hairymnstr/d1000_hardware/(threads)

Thread 1 (2023-10-13):

C11 and C12 should be 0603 not 0805

hairymnstr, 2023-10-13:
Easy to bodge but footprint should be 0603
