hairymnstr/d1000_hardware/audio.kicad_sch

## KiCad design audio.kicad_sch (2023-09-26)

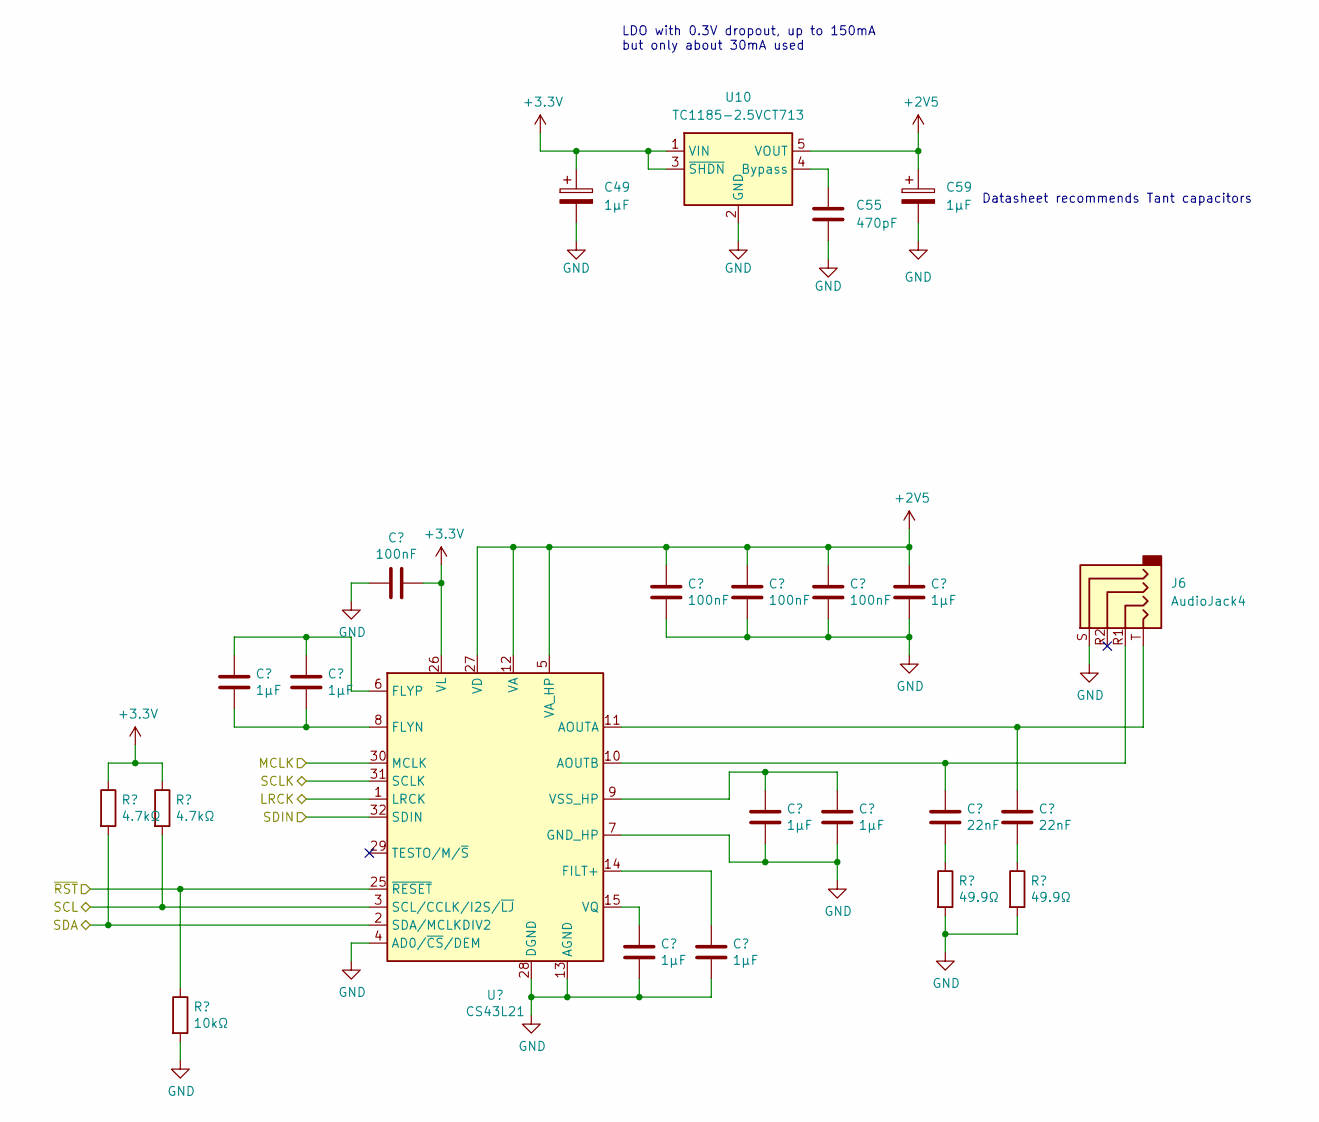
[picture p1: schematic audio.kicad_sch]

Parts:
C46, C47, C50, C52, C54, C57, C58: 1µF; C_0603_1608Metric_Pad1.08x0.95mm_HandSolder
C48, C51, C53, C56: 100nF; C_0603_1608Metric_Pad1.08x0.95mm_HandSolder; Part number Generic 0603 X7R 50V 10%
C49, C59: 1µF; CP_EIA-3216-12_Kemet-S_Pad1.58x1.35mm_HandSolder
C55: 470pF; C_0603_1608Metric_Pad1.08x0.95mm_HandSolder
C60, C61: 22nF; C_0603_1608Metric_Pad1.08x0.95mm_HandSolder
J6: AudioJack4; Cliff_Electronic_Components_Limited-FC68128-0
R59, R60: 4.7kΩ; R_0603_1608Metric_Pad0.98x0.95mm_HandSolder
R61: 10kΩ; R_0603_1608Metric_Pad0.98x0.95mm_HandSolder
R62, R63: 49.9Ω; R_0603_1608Metric_Pad0.98x0.95mm_HandSolder
U9: CS43L21; QFN-32-1EP_5x5mm_P0.5mm_EP3.45x3.45mm
U10: TC1185-2.5VCT713; SOT-23-5

Connections:
+2V5: C51.1, C53.1, C56.1, C58.1, C59.1, U9.5 (VA_HP), U9.12 (VA), U9.27 (VD), U10.5 (VOUT)
+3.3V: C48.1, C49.1, R59.1, R60.1, U9.26 (VL), U10.1 (VIN), U10.3 (~SHDN)
GND: C48.2, C49.2, C50.2, C51.2, C52.2, C53.2, C54.2, C55.2, C56.2, C57.2, C58.2, C59.2, J6.S, R61.2, R62.2, R63.2, U9.4 (AD0/~CS/DEM), U9.7 (GND_HP), U9.13 (AGND), U9.28 (DGND), U9.33 (AGND), U10.2 (GND)
LRCK: U9.1 (LRCK)
MCLK: U9.30 (MCLK)
unnamed: C46.1, C47.1, U9.6 (FLYP)
unnamed: C46.2, C47.2, U9.8 (FLYN)
unnamed: C50.1, U9.15 (VQ)
unnamed: C52.1, U9.14 (FILT+)
unnamed: C54.1, C57.1, U9.9 (VSS_HP)
unnamed: C55.1, U10.4 (Bypass)
unnamed: C60.1, J6.R1, U9.10 (AOUTB)
unnamed: C60.2, R62.1
unnamed: C61.1, J6.T, U9.11 (AOUTA)
unnamed: C61.2, R63.1
SCL: R60.2, U9.3 (SCL/CCLK/I2S/~LJ)
SCLK: U9.31 (SCLK)
SDA: R59.2, U9.2 (SDA/MCLKDIV2)
SDIN: U9.32 (SDIN)
~RST: R61.1, U9.25 (~RESET)

Notes on the sheet:
LDO with 0.3V dropout, up to 150mA but only about 30mA used
Datasheet recommends Tant capacitors
