hairymnstr/d1000_hardware/cpu.kicad_sch

## KiCad design cpu.kicad_sch (2023-09-26)

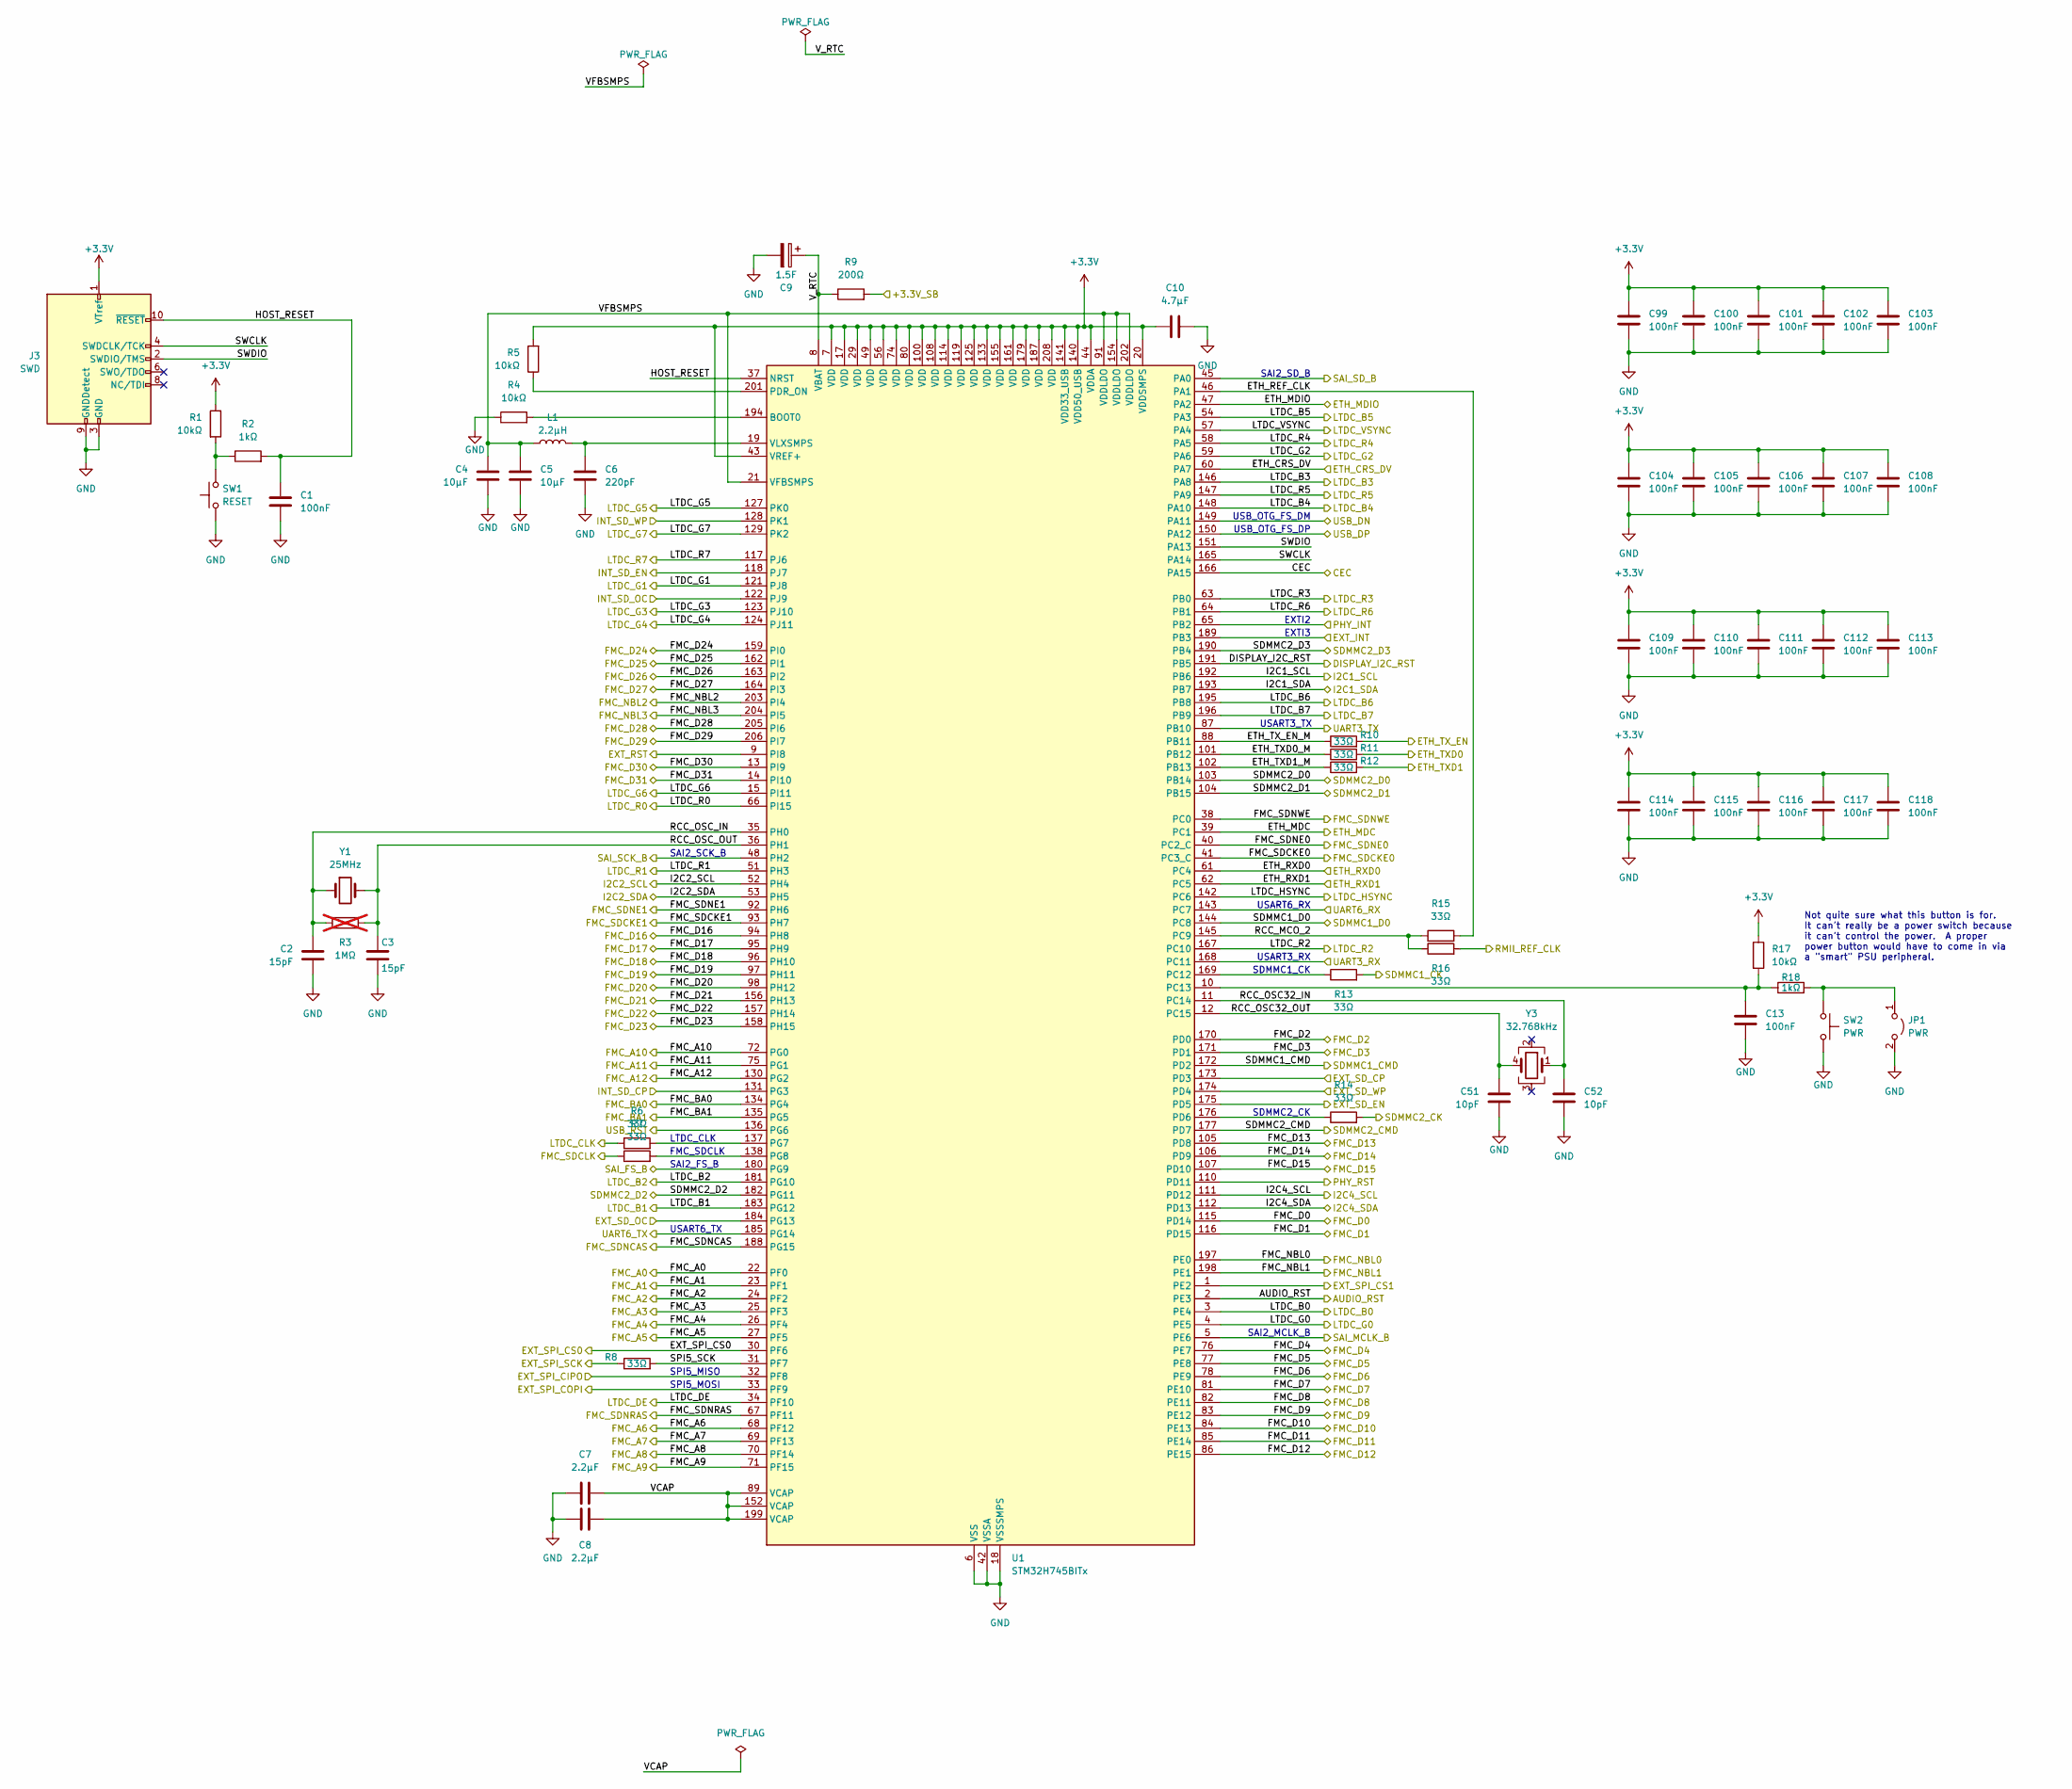
[picture p2: schematic cpu.kicad_sch]

Parts:
C1, C13: 100nF; C_0603_1608Metric_Pad1.08x0.95mm_HandSolder; Part number Generic 0603 X7R 50V 10%
C2, C3: 15pF; C_0603_1608Metric_Pad1.08x0.95mm_HandSolder
C4, C5: 10µF; C_0805_2012Metric_Pad1.18x1.45mm_HandSolder
C6: 220pF; C_0603_1608Metric_Pad1.08x0.95mm_HandSolder
C7, C8: 2.2µF; C_0603_1608Metric_Pad1.08x0.95mm_HandSolder
C9: 1.5F; SUPERCAP_D20mm_H6mm
C10: 4.7µF; C_0805_2012Metric_Pad1.18x1.45mm_HandSolder
C51, C52: 10pF; C_0805_2012Metric
C99, C100, C101, C102, C103, C104, C105, C106, C107, C108, C109, C110, C111, C112, C113, C114, C115, C116, C117, C118: 100nF; C_0603_1608Metric_Pad1.08x0.95mm_HandSolder
J3: SWD; SAMTEC_SHF-SM_5x2
JP1: PWR; PinHeader_1x02_P2.54mm_Vertical
L1: 2.2µH; L_1008_2520Metric_Pad1.43x2.20mm_HandSolder
R1, R4, R5, R17: 10kΩ; R_0603_1608Metric_Pad0.98x0.95mm_HandSolder
R2, R18: 1kΩ; R_0603_1608Metric_Pad0.98x0.95mm_HandSolder
R3: 1MΩ; R_0603_1608Metric_Pad0.98x0.95mm_HandSolder; not fitted
R6, R7, R8, R10, R11, R12, R13, R14, R15, R16: 33Ω; R_0603_1608Metric_Pad0.98x0.95mm_HandSolder
R9: 200Ω; R_0603_1608Metric_Pad0.98x0.95mm_HandSolder
SW1: RESET; SW_Tactile_SPST_Angled_PTS645Vx58-2LFS
SW2: PWR; SW_Tactile_SPST_Angled_PTS645Vx58-2LFS
U1: STM32H745BITx; LQFP-208_28x28mm_P0.5mm
Y1: 25MHz; Crystal_SMD_Abracon_ABM3-2Pin_5.0x3.2mm_HandSoldering; Farnell 2101328
Y3: 32.768kHz; Crystal_SMD_SeikoEpson_MC306-4Pin_8.0x3.2mm

Connections:
+3.3V: C10.1, C99.1, C100.1, C101.1, C102.1, C103.1, C104.1, C105.1, C106.1, C107.1, C108.1, C109.1, C110.1, C111.1, C112.1, C113.1, C114.1, C115.1, C116.1, C117.1, C118.1, J3.1 (VTref), R1.1, R5.2, R17.1, U1.7 (VDD), U1.17 (VDD), U1.20 (VDDSMPS), U1.29 (VDD), U1.43 (VREF+), U1.44 (VDDA), U1.49 (VDD), U1.56 (VDD), U1.74 (VDD), U1.80 (VDD), U1.100 (VDD), U1.108 (VDD), U1.114 (VDD), U1.119 (VDD), U1.125 (VDD), U1.133 (VDD), U1.140 (VDD50_USB), U1.141 (VDD33_USB), U1.155 (VDD), U1.161 (VDD), U1.179 (VDD), U1.187 (VDD), U1.208 (VDD)
+3.3V_SB: R9.2
AUDIO_RST: U1.2 (PE3)
CEC: U1.166 (PA15)
DISPLAY_I2C_RST: U1.191 (PB5)
ETH_CRS_DV: U1.60 (PA7)
ETH_MDC: U1.39 (PC1)
ETH_MDIO: U1.47 (PA2)
ETH_REF_CLK: R15.2, U1.46 (PA1)
ETH_RXD0: U1.61 (PC4)
ETH_RXD1: U1.62 (PC5)
ETH_TXD0: R11.2
ETH_TXD0_M: R11.1, U1.101 (PB12)
ETH_TXD1: R12.2
ETH_TXD1_M: R12.1, U1.102 (PB13)
ETH_TX_EN: R10.2
ETH_TX_EN_M: R10.1, U1.88 (PB11)
EXT_INT: U1.189 (PB3)
EXT_RST: U1.9 (PI8)
EXT_SD_CP: U1.173 (PD3)
EXT_SD_EN: U1.175 (PD5)
EXT_SD_OC: U1.184 (PG13)
EXT_SD_WP: U1.174 (PD4)
EXT_SPI_CIPO: U1.32 (PF8)
EXT_SPI_COPI: U1.33 (PF9)
EXT_SPI_CS0: U1.30 (PF6)
EXT_SPI_CS1: U1.1 (PE2)
EXT_SPI_SCK: R8.1
FMC_A0: U1.22 (PF0)
FMC_A1: U1.23 (PF1)
FMC_A2: U1.24 (PF2)
FMC_A3: U1.25 (PF3)
FMC_A4: U1.26 (PF4)
FMC_A5: U1.27 (PF5)
FMC_A6: U1.68 (PF12)
FMC_A7: U1.69 (PF13)
FMC_A8: U1.70 (PF14)
FMC_A9: U1.71 (PF15)
FMC_A10: U1.72 (PG0)
FMC_A11: U1.75 (PG1)
FMC_A12: U1.130 (PG2)
FMC_BA0: U1.134 (PG4)
FMC_BA1: U1.135 (PG5)
FMC_D0: U1.115 (PD14)
FMC_D1: U1.116 (PD15)
FMC_D2: U1.170 (PD0)
FMC_D3: U1.171 (PD1)
FMC_D4: U1.76 (PE7)
FMC_D5: U1.77 (PE8)
FMC_D6: U1.78 (PE9)
FMC_D7: U1.81 (PE10)
FMC_D8: U1.82 (PE11)
FMC_D9: U1.83 (PE12)
FMC_D10: U1.84 (PE13)
FMC_D11: U1.85 (PE14)
FMC_D12: U1.86 (PE15)
FMC_D13: U1.105 (PD8)
FMC_D14: U1.106 (PD9)
FMC_D15: U1.107 (PD10)
FMC_D16: U1.94 (PH8)
FMC_D17: U1.95 (PH9)
FMC_D18: U1.96 (PH10)
FMC_D19: U1.97 (PH11)
FMC_D20: U1.98 (PH12)
FMC_D21: U1.156 (PH13)
FMC_D22: U1.157 (PH14)
FMC_D23: U1.158 (PH15)
FMC_D24: U1.159 (PI0)
FMC_D25: U1.162 (PI1)
FMC_D26: U1.163 (PI2)
FMC_D27: U1.164 (PI3)
FMC_D28: U1.205 (PI6)
FMC_D29: U1.206 (PI7)
FMC_D30: U1.13 (PI9)
FMC_D31: U1.14 (PI10)
FMC_NBL0: U1.197 (PE0)
FMC_NBL1: U1.198 (PE1)
FMC_NBL2: U1.203 (PI4)
FMC_NBL3: U1.204 (PI5)
FMC_SDCKE0: U1.41 (PC3_C)
FMC_SDCKE1: U1.93 (PH7)
FMC_SDCLK: R7.1
FMC_SDNCAS: U1.188 (PG15)
FMC_SDNE0: U1.40 (PC2_C)
FMC_SDNE1: U1.92 (PH6)
FMC_SDNRAS: U1.67 (PF11)
FMC_SDNWE: U1.38 (PC0)
GND: C1.2, C2.2, C3.2, C4.2, C5.2, C6.2, C7.1, C8.1, C9.2, C10.2, C13.2, C51.2, C52.2, C99.2, C100.2, C101.2, C102.2, C103.2, C104.2, C105.2, C106.2, C107.2, C108.2, C109.2, C110.2, C111.2, C112.2, C113.2, C114.2, C115.2, C116.2, C117.2, C118.2, J3.3 (GND), J3.5 (GND), J3.9 (GNDDetect), JP1.2 (B), R4.1, SW1.1, SW2.2, U1.6 (VSS), U1.16 (VSS), U1.18 (VSSSMPS), U1.28 (VSS), U1.42 (VSSA), U1.50 (VSS), U1.55 (VSS), U1.73 (VSS), U1.79 (VSS), U1.90 (VSS), U1.99 (VSS), U1.109 (VSS), U1.113 (VSS), U1.120 (VSS), U1.126 (VSS), U1.132 (VSS), U1.139 (VSS), U1.153 (VSS), U1.160 (VSS), U1.178 (VSS), U1.186 (VSS), U1.200 (VSS), U1.207 (VSS)
HOST_RESET: C1.1, J3.10 (~RESET), R2.2, U1.37 (NRST)
I2C1_SCL: U1.192 (PB6)
I2C1_SDA: U1.193 (PB7)
I2C2_SCL: U1.52 (PH4)
I2C2_SDA: U1.53 (PH5)
I2C4_SCL: U1.111 (PD12)
I2C4_SDA: U1.112 (PD13)
INT_SD_CP: U1.131 (PG3)
INT_SD_EN: U1.118 (PJ7)
INT_SD_OC: U1.122 (PJ9)
INT_SD_WP: U1.128 (PK1)
LTDC_B0: U1.3 (PE4)
LTDC_B1: U1.183 (PG12)
LTDC_B2: U1.181 (PG10)
LTDC_B3: U1.146 (PA8)
LTDC_B4: U1.148 (PA10)
LTDC_B5: U1.54 (PA3)
LTDC_B6: U1.195 (PB8)
LTDC_B7: U1.196 (PB9)
LTDC_CLK: R6.1
LTDC_DE: U1.34 (PF10)
LTDC_G0: U1.4 (PE5)
LTDC_G1: U1.121 (PJ8)
LTDC_G2: U1.59 (PA6)
LTDC_G3: U1.123 (PJ10)
LTDC_G4: U1.124 (PJ11)
LTDC_G5: U1.127 (PK0)
LTDC_G6: U1.15 (PI11)
LTDC_G7: U1.129 (PK2)
LTDC_HSYNC: U1.142 (PC6)
LTDC_R0: U1.66 (PI15)
LTDC_R1: U1.51 (PH3)
LTDC_R2: U1.167 (PC10)
LTDC_R3: U1.63 (PB0)
LTDC_R4: U1.58 (PA5)
LTDC_R5: U1.147 (PA9)
LTDC_R6: U1.64 (PB1)
LTDC_R7: U1.117 (PJ6)
LTDC_VSYNC: U1.57 (PA4)
unnamed: C6.1, L1.2, U1.19 (VLXSMPS)
unnamed: C13.1, R17.2, R18.1, U1.10 (PC13)
unnamed: JP1.1 (A), R18.2, SW2.1
unnamed: R1.2, R2.1, SW1.2
unnamed: R4.2, U1.194 (BOOT0)
unnamed: R5.1, U1.201 (PDR_ON)
unnamed: R6.2, U1.137 (PG7)
unnamed: R7.2, U1.138 (PG8)
unnamed: R13.1, U1.169 (PC12)
unnamed: R14.1, U1.176 (PD6)
PHY_INT: U1.65 (PB2)
PHY_RST: U1.110 (PD11)
RCC_MCO_2: R15.1, R16.1, U1.145 (PC9)
RCC_OSC32_IN: C52.1, U1.11 (PC14), Y3.1
RCC_OSC32_OUT: C51.1, U1.12 (PC15), Y3.4
RCC_OSC_IN: C2.1, R3.1, U1.35 (PH0), Y1.1
RCC_OSC_OUT: C3.1, R3.2, U1.36 (PH1), Y1.2
RMII_REF_CLK: R16.2
SAI_FS_B: U1.180 (PG9)
SAI_MCLK_B: U1.5 (PE6)
SAI_SCK_B: U1.48 (PH2)
SAI_SD_B: U1.45 (PA0)
SDMMC1_CK: R13.2
SDMMC1_CMD: U1.172 (PD2)
SDMMC1_D0: U1.144 (PC8)
SDMMC2_CK: R14.2
SDMMC2_CMD: U1.177 (PD7)
SDMMC2_D0: U1.103 (PB14)
SDMMC2_D1: U1.104 (PB15)
SDMMC2_D2: U1.182 (PG11)
SDMMC2_D3: U1.190 (PB4)
SPI5_SCK: R8.2, U1.31 (PF7)
SWCLK: J3.4 (SWDCLK/TCK), U1.165 (PA14)
SWDIO: J3.2 (SWDIO/TMS), U1.151 (PA13)
UART3_RX: U1.168 (PC11)
UART3_TX: U1.87 (PB10)
UART6_RX: U1.143 (PC7)
UART6_TX: U1.185 (PG14)
USB_DN: U1.149 (PA11)
USB_DP: U1.150 (PA12)
USB_RST: U1.136 (PG6)
VCAP: C7.2, C8.2, U1.89 (VCAP), U1.152 (VCAP), U1.199 (VCAP)
VFBSMPS: C4.1, C5.1, L1.1, U1.21 (VFBSMPS), U1.91 (VDDLDO), U1.154 (VDDLDO), U1.202 (VDDLDO)
V_RTC: C9.1, R9.1, U1.8 (VBAT)

Notes on the sheet:
USART3_RX
SPI5_MOSI
SAI2_SD_B
LTDC_CLK
SPI5_MISO
SAI2_FS_B
EXTI2
FMC_SDCLK
USART6_TX
EXTI3
SAI2_SCK_B
USB_OTG_FS_DP
SDMMC2_CK
USART6_RX
SAI2_MCLK_B
SDMMC1_CK
Not quite sure what this button is for. It can't really be a power switch because it can't control the power. A proper power button would have to come in via a "smart" PSU peripheral.
USB_OTG_FS_DM
USART3_TX
