hairymnstr/d1000_hardware/d1000.kicad_sch

## KiCad design d1000.kicad_sch (2023-09-26)

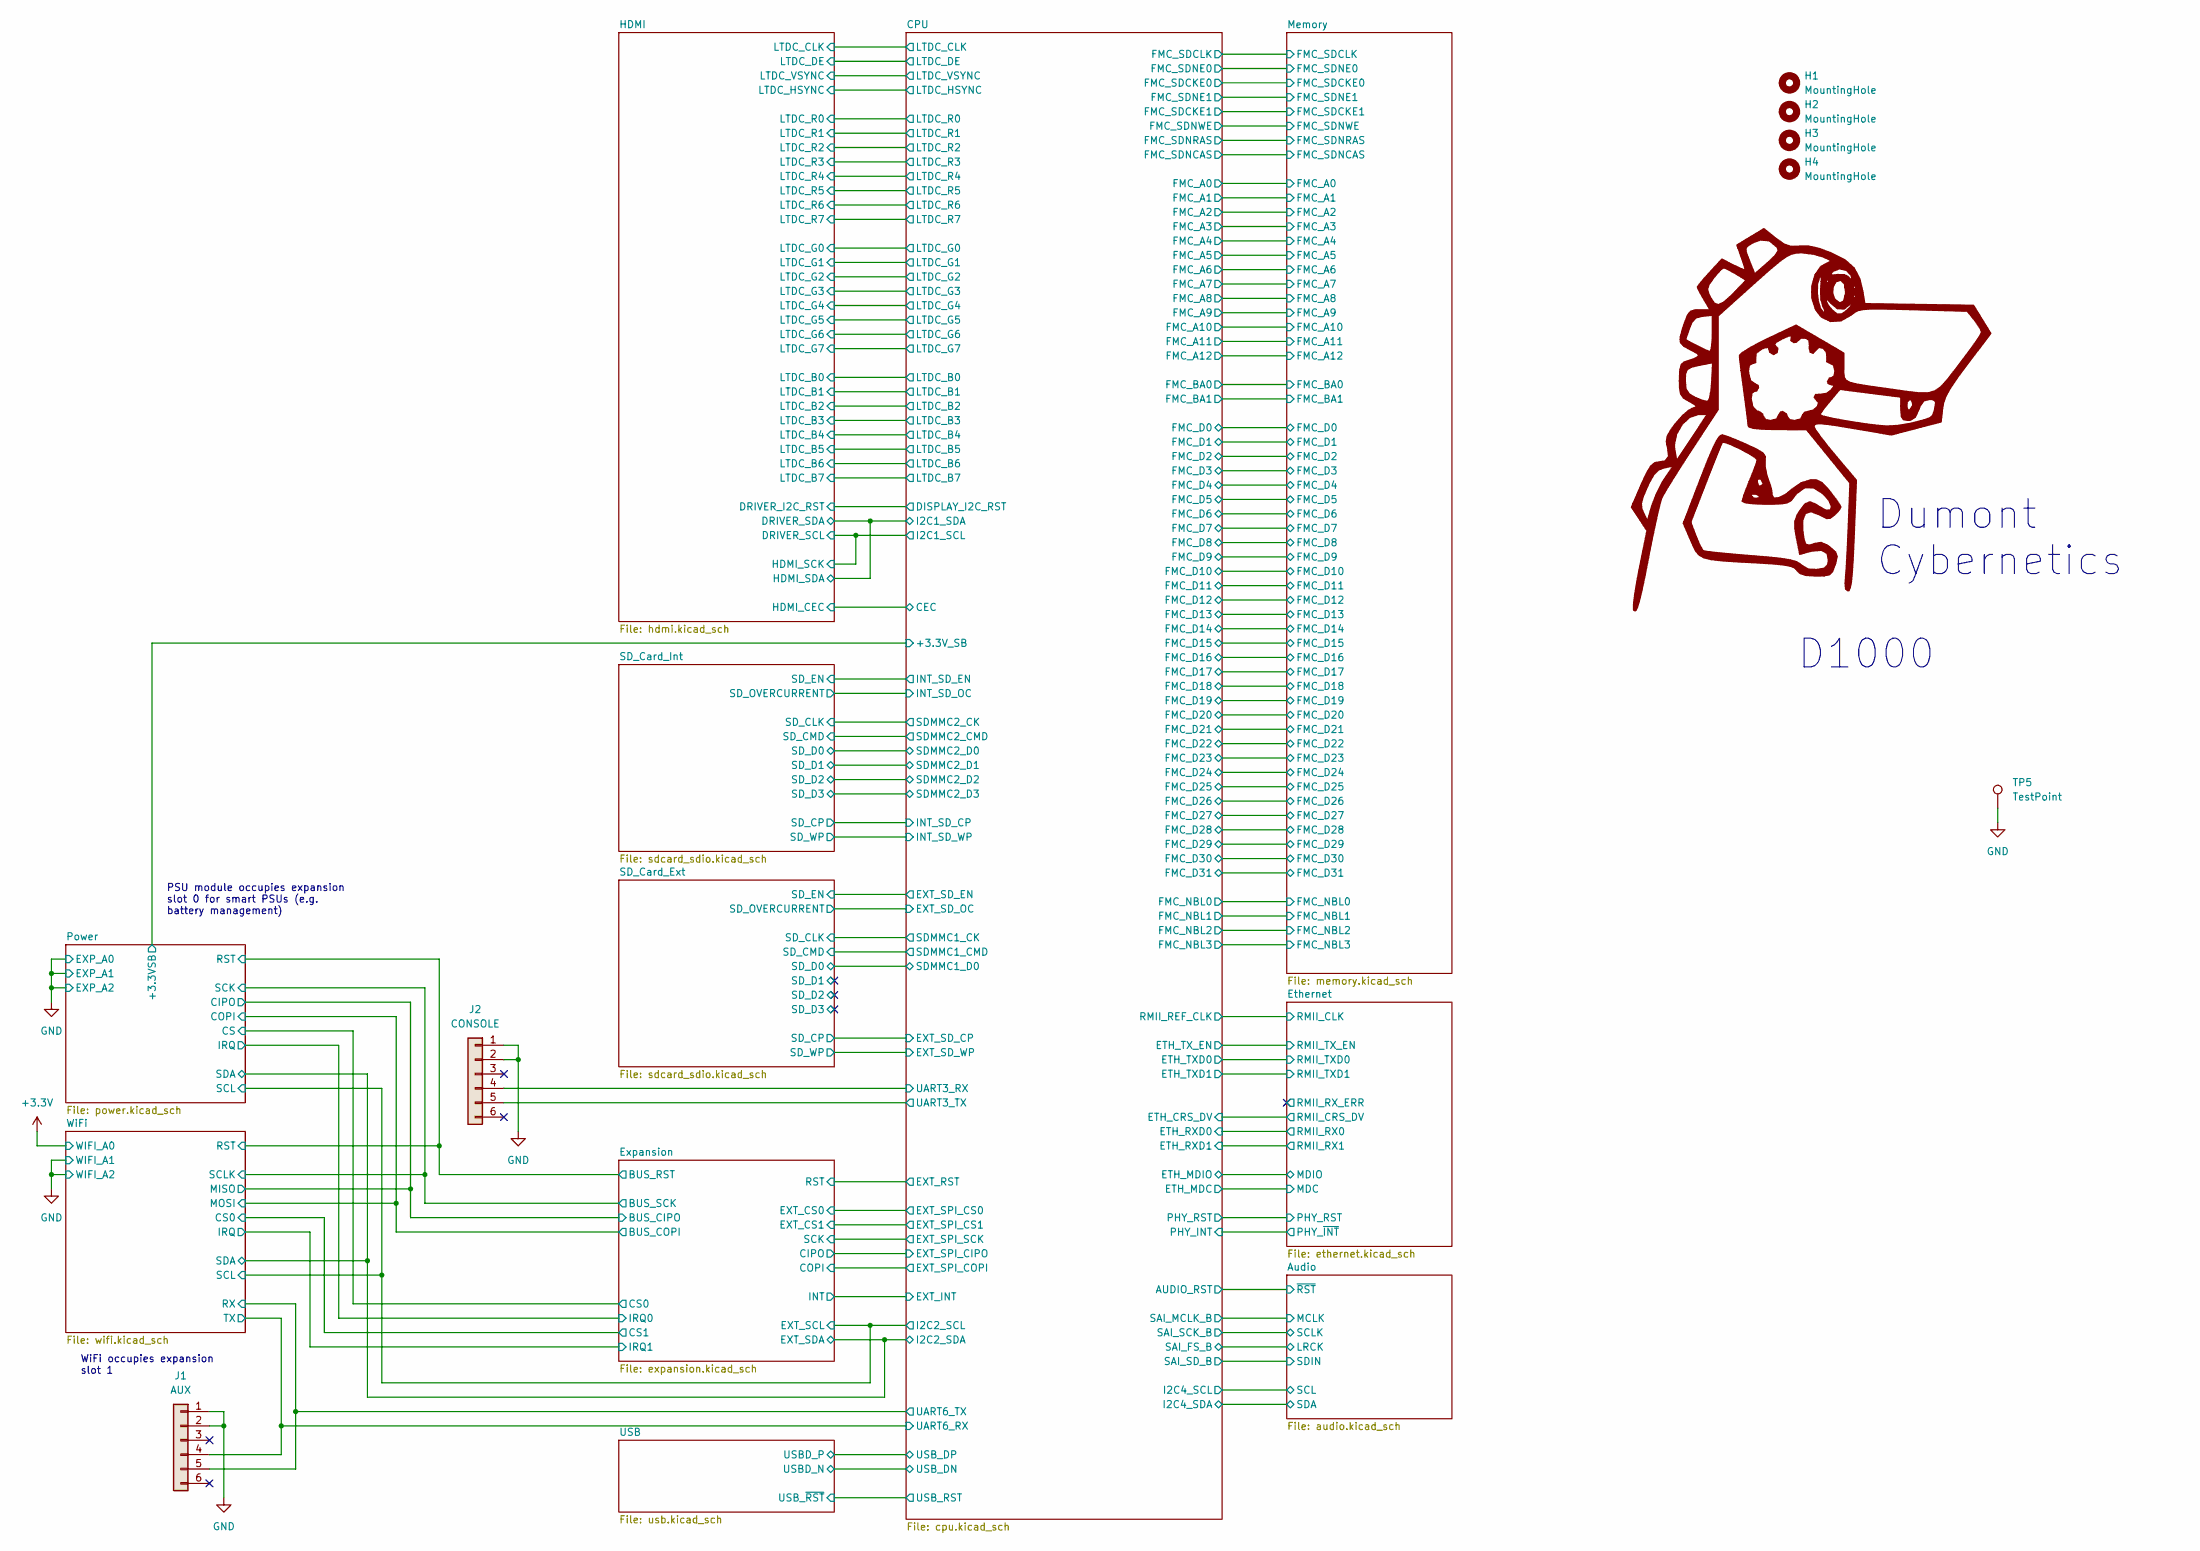
[picture p3: schematic d1000.kicad_sch]

Parts:
G1: LOGO; dclogo
H1, H2, H3, H4: MountingHole; MountingHole_3.2mm_M3
J1: AUX; PinHeader_1x06_P2.54mm_Vertical
J2: CONSOLE; PinHeader_1x06_P2.54mm_Vertical
TP5: TestPoint; TestPoint_Keystone_5019_Minature

Connections:
GND: J1.1, J1.2, J2.1, J2.2, TP5.1
RX: J1.5
TX: J1.4
UART3_RX: J2.4
UART3_TX: J2.5

Notes on the sheet:
D1000
WiFi occupies expansion slot 1
Dumont Cybernetics
PSU module occupies expansion slot 0 for smart PSUs (e.g. battery management)
