hairymnstr/d1000_hardware/ethernet.kicad_sch

## KiCad design ethernet.kicad_sch (2023-09-26)

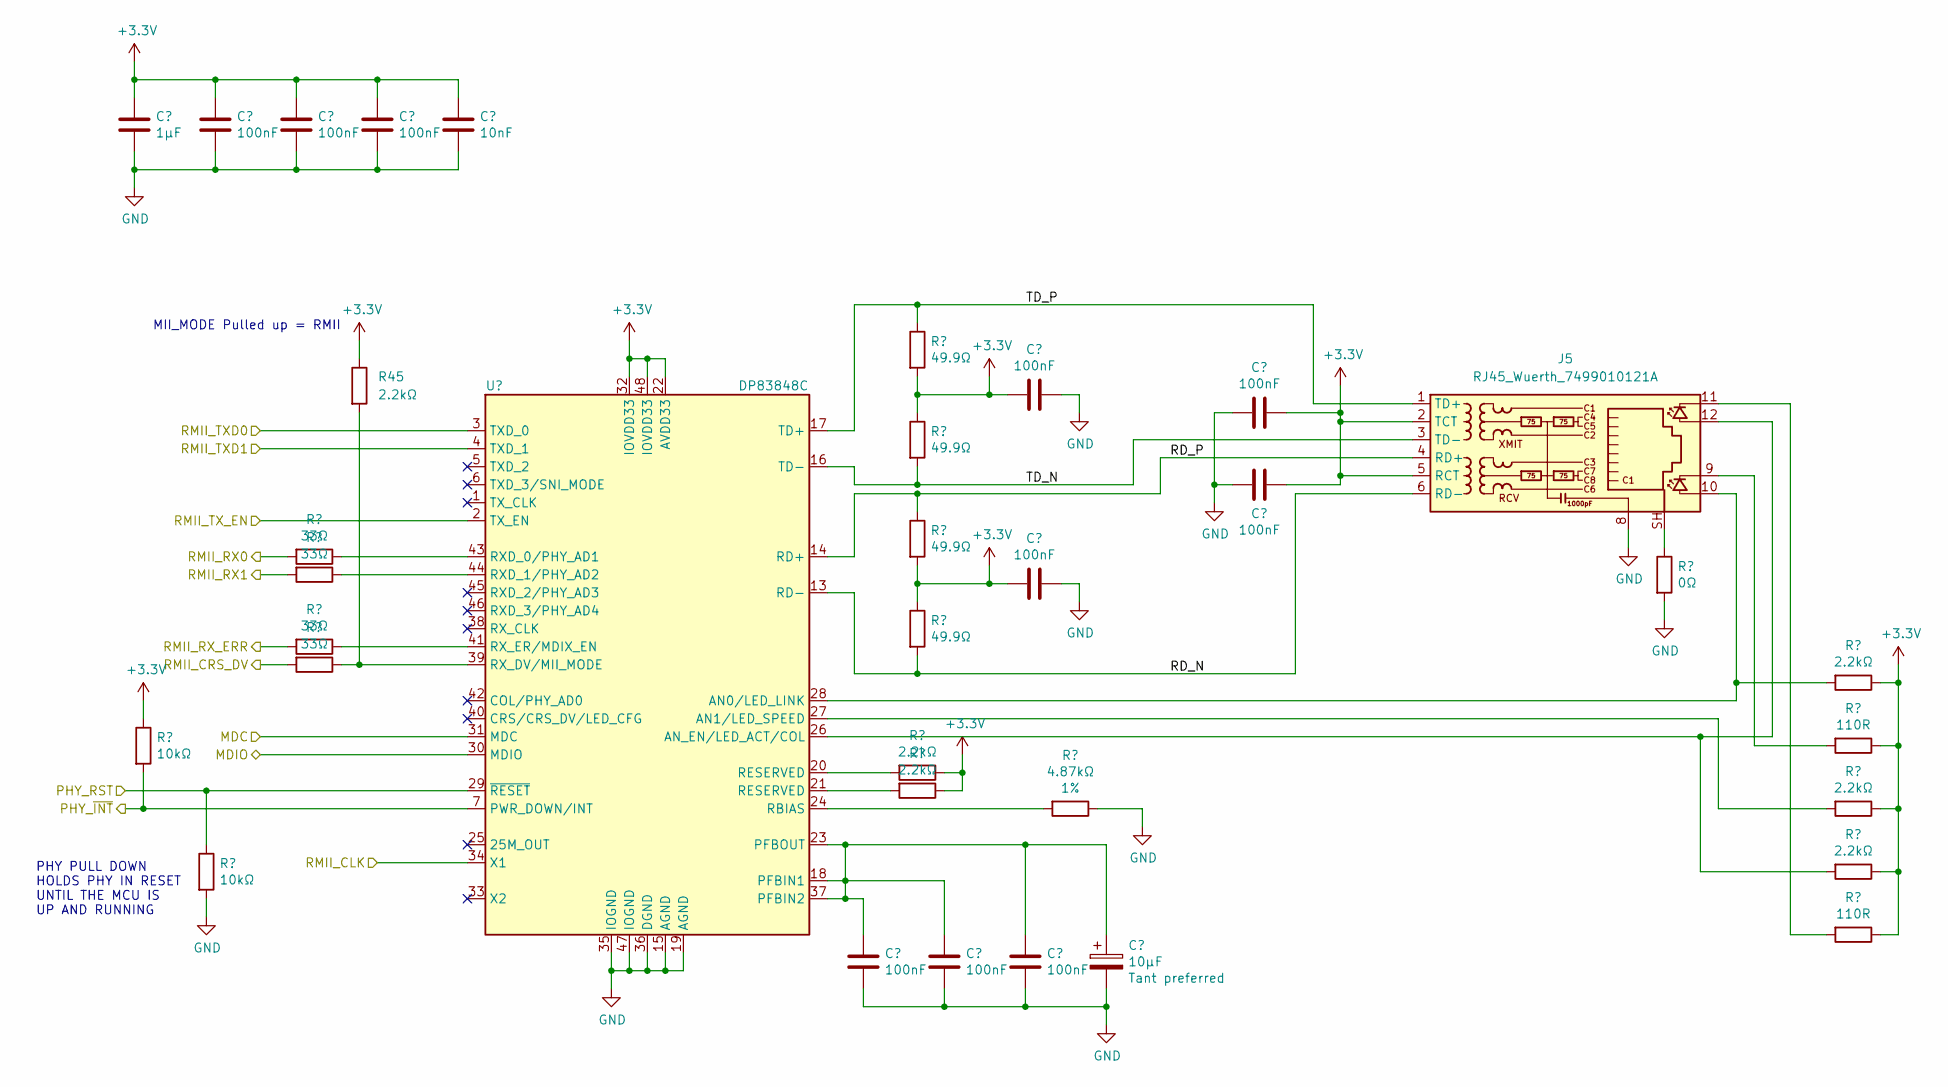
[picture p4: schematic ethernet.kicad_sch]

Parts:
C33: 1µF; C_0603_1608Metric_Pad1.08x0.95mm_HandSolder
C34, C35, C36, C38, C39, C40, C41, C42, C44, C45: 100nF; C_0603_1608Metric_Pad1.08x0.95mm_HandSolder; Part number Generic 0603 X7R 50V 10%
C37: 10nF; C_0603_1608Metric_Pad1.08x0.95mm_HandSolder
C43: 10µF; C_0805_2012Metric_Pad1.18x1.45mm_HandSolder
J5: RJ45_Wuerth_7499010121A; RJ45_Wuerth_7499010121A_Horizontal
R39, R40: 10kΩ; R_0603_1608Metric_Pad0.98x0.95mm_HandSolder
R41, R42, R43, R44: 33Ω; R_0603_1608Metric_Pad0.98x0.95mm_HandSolder
R45, R50, R51, R54, R56, R57: 2.2kΩ; R_0603_1608Metric_Pad0.98x0.95mm_HandSolder
R46, R47, R48, R49: 49.9Ω; R_0603_1608Metric_Pad0.98x0.95mm_HandSolder
R52: 4.87kΩ; R_0603_1608Metric_Pad0.98x0.95mm_HandSolder; Tolerance 1%
R53: 0Ω; R_0603_1608Metric_Pad0.98x0.95mm_HandSolder
R55, R58: 110R; R_0603_1608Metric_Pad0.98x0.95mm_HandSolder
U8: DP83848C; LQFP-48_7x7mm_P0.5mm

Connections:
+3.3V: C33.1, C34.1, C35.1, C36.1, C37.1, C41.2, C42.2, C44.1, C45.1, J5.2 (TCT), J5.5 (RCT), R39.1, R45.1, R46.2, R47.1, R48.2, R49.1, R50.1, R51.1, R54.1, R55.1, R56.1, R57.1, R58.1, U8.22 (AVDD33), U8.32 (IOVDD33), U8.48 (IOVDD33)
GND: C33.2, C34.2, C35.2, C36.2, C37.2, C38.2, C39.2, C40.2, C41.1, C42.1, C43.2, C44.2, C45.2, J5.8, R40.2, R52.1, R53.2, U8.15 (AGND), U8.19 (AGND), U8.35 (IOGND), U8.36 (DGND), U8.47 (IOGND)
MDC: U8.31 (MDC)
MDIO: U8.30 (MDIO)
unnamed: C38.1, C39.1, C40.1, C43.1, U8.18 (PFBIN1), U8.23 (PFBOUT), U8.37 (PFBIN2)
unnamed: J5.9, R55.2
unnamed: J5.10, R54.2, U8.28 (AN0/LED_LINK)
unnamed: J5.11, R58.2
unnamed: J5.12, R57.2, U8.26 (AN_EN/LED_ACT/COL)
unnamed: J5.SH, R53.1
unnamed: R41.1, U8.43 (RXD_0/PHY_AD1)
unnamed: R42.1, U8.44 (RXD_1/PHY_AD2)
unnamed: R43.1, U8.41 (RX_ER/MDIX_EN)
unnamed: R44.1, R45.2, U8.39 (RX_DV/MII_MODE)
unnamed: R50.2, U8.20 (RESERVED)
unnamed: R51.2, U8.21 (RESERVED)
unnamed: R52.2, U8.24 (RBIAS)
unnamed: R56.2, U8.27 (AN1/LED_SPEED)
PHY_RST: R40.1, U8.29 (~RESET)
PHY_~INT: R39.2, U8.7 (PWR_DOWN/INT)
RD_N: J5.6 (RD-), R49.2, U8.13 (RD-)
RD_P: J5.4 (RD+), R48.1, U8.14 (RD+)
RMII_CLK: U8.34 (X1)
RMII_CRS_DV: R44.2
RMII_RX0: R41.2
RMII_RX1: R42.2
RMII_RX_ERR: R43.2
RMII_TXD0: U8.3 (TXD_0)
RMII_TXD1: U8.4 (TXD_1)
RMII_TX_EN: U8.2 (TX_EN)
TD_N: J5.3 (TD-), R47.2, U8.16 (TD-)
TD_P: J5.1 (TD+), R46.1, U8.17 (TD+)

Notes on the sheet:
MII_MODE Pulled up = RMII
PHY PULL DOWN HOLDS PHY IN RESET UNTIL THE MCU IS UP AND RUNNING
