hairymnstr/d1000_hardware/expansion.kicad_sch

## KiCad design expansion.kicad_sch (2023-09-26)

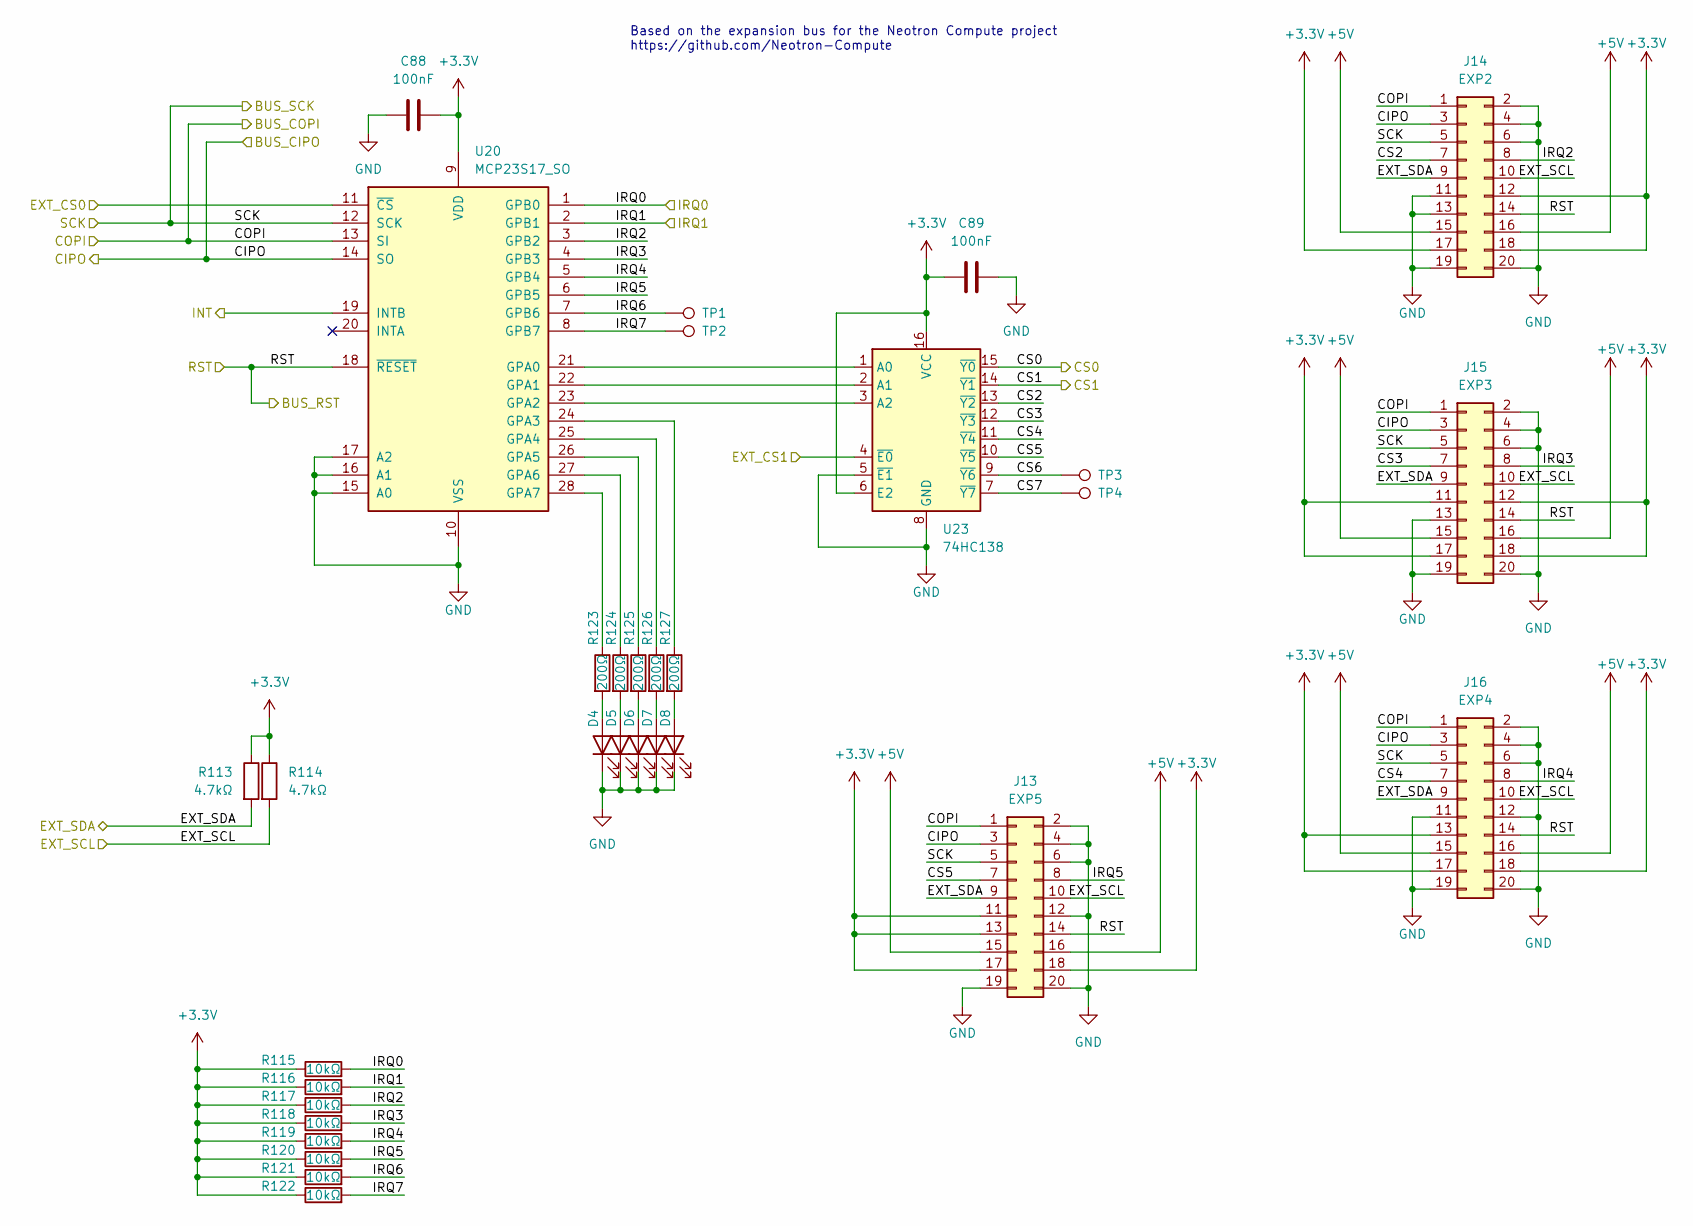
[picture p5: schematic expansion.kicad_sch]

Parts:
C88, C89: 100nF; C_0603_1608Metric_Pad1.08x0.95mm_HandSolder; Part number Generic 0603 X7R 50V 10%
D4, D5, D6, D7, D8: LED; D_0603_1608Metric
J13: EXP5; TE_5-5530843-0
J14: EXP2; TE_5-5530843-0
J15: EXP3; TE_5-5530843-0
J16: EXP4; TE_5-5530843-0
R113, R114: 4.7kΩ; R_0603_1608Metric_Pad0.98x0.95mm_HandSolder
R115, R116, R117, R118, R119, R120, R121, R122: 10kΩ; R_0603_1608Metric_Pad0.98x0.95mm_HandSolder
R123, R124, R125, R126, R127: 200Ω; R_0603_1608Metric_Pad0.98x0.95mm_HandSolder
TP1: IRQ6; PinHeader_1x01_P2.54mm_Vertical
TP2: IRQ7; PinHeader_1x01_P2.54mm_Vertical
TP3: CS6; PinHeader_1x01_P2.54mm_Vertical
TP4: CS7; PinHeader_1x01_P2.54mm_Vertical
U20: MCP23S17_SO; SOIC-28W_7.5x17.9mm_P1.27mm
U23: 74HC138; SOIC-16_3.9x9.9mm_P1.27mm

Connections:
+3.3V: C88.2, C89.1, J13.11, J13.13, J13.17, J13.18, J14.12, J14.17, J14.18, J15.11, J15.12, J15.17, J15.18, J16.13, J16.17, J16.18, R113.1, R114.1, R115.1, R116.1, R117.1, R118.1, R119.1, R120.1, R121.1, R122.1, U20.9 (VDD), U23.6 (E2), U23.16 (VCC)
+5V: J13.15, J13.16, J14.15, J14.16, J15.15, J15.16, J16.15, J16.16
BUS_CIPO: J13.3, J14.3, J15.3, J16.3, U20.14 (SO)
BUS_COPI: J13.1, J14.1, J15.1, J16.1, U20.13 (SI)
BUS_RST: J13.14, J14.14, J15.14, J16.14, U20.18 (~RESET)
BUS_SCK: J13.5, J14.5, J15.5, J16.5, U20.12 (SCK)
CS0: U23.15 (~Y0)
CS1: U23.14 (~Y1)
CS2: J14.7, U23.13 (~Y2)
CS3: J15.7, U23.12 (~Y3)
CS4: J16.7, U23.11 (~Y4)
CS5: J13.7, U23.10 (~Y5)
CS6: TP3.1, U23.9 (~Y6)
CS7: TP4.1, U23.7 (~Y7)
EXT_CS0: U20.11 (~CS)
EXT_CS1: U23.4 (~E0)
EXT_SCL: J13.10, J14.10, J15.10, J16.10, R114.2
EXT_SDA: J13.9, J14.9, J15.9, J16.9, R113.2
GND: C88.1, C89.2, D4.1 (K), D5.1 (K), D6.1 (K), D7.1 (K), D8.1 (K), J13.2, J13.4, J13.6, J13.12, J13.19, J13.20, J14.2, J14.4, J14.6, J14.11, J14.13, J14.19, J14.20, J15.2, J15.4, J15.6, J15.13, J15.19, J15.20, J16.2, J16.4, J16.6, J16.11, J16.12, J16.19, J16.20, U20.10 (VSS), U20.15 (A0), U20.16 (A1), U20.17 (A2), U23.5 (~E1), U23.8 (GND)
INT: U20.19 (INTB)
IRQ0: R115.2, U20.1 (GPB0)
IRQ1: R116.2, U20.2 (GPB1)
IRQ2: J14.8, R117.2, U20.3 (GPB2)
IRQ3: J15.8, R118.2, U20.4 (GPB3)
IRQ4: J16.8, R119.2, U20.5 (GPB4)
IRQ5: J13.8, R120.2, U20.6 (GPB5)
IRQ6: R121.2, TP1.1, U20.7 (GPB6)
IRQ7: R122.2, TP2.1, U20.8 (GPB7)
unnamed: D4.2 (A), R123.2
unnamed: D5.2 (A), R124.2
unnamed: D6.2 (A), R125.2
unnamed: D7.2 (A), R126.2
unnamed: D8.2 (A), R127.2
unnamed: R123.1, U20.28 (GPA7)
unnamed: R124.1, U20.27 (GPA6)
unnamed: R125.1, U20.26 (GPA5)
unnamed: R126.1, U20.25 (GPA4)
unnamed: R127.1, U20.24 (GPA3)
unnamed: U20.21 (GPA0), U23.1 (A0)
unnamed: U20.22 (GPA1), U23.2 (A1)
unnamed: U20.23 (GPA2), U23.3 (A2)

Notes on the sheet:
Based on the expansion bus for the Neotron Compute project https://github.com/Neotron-Compute
