hairymnstr/d1000_hardware/hdmi.kicad_sch

## KiCad design hdmi.kicad_sch (2023-09-26)

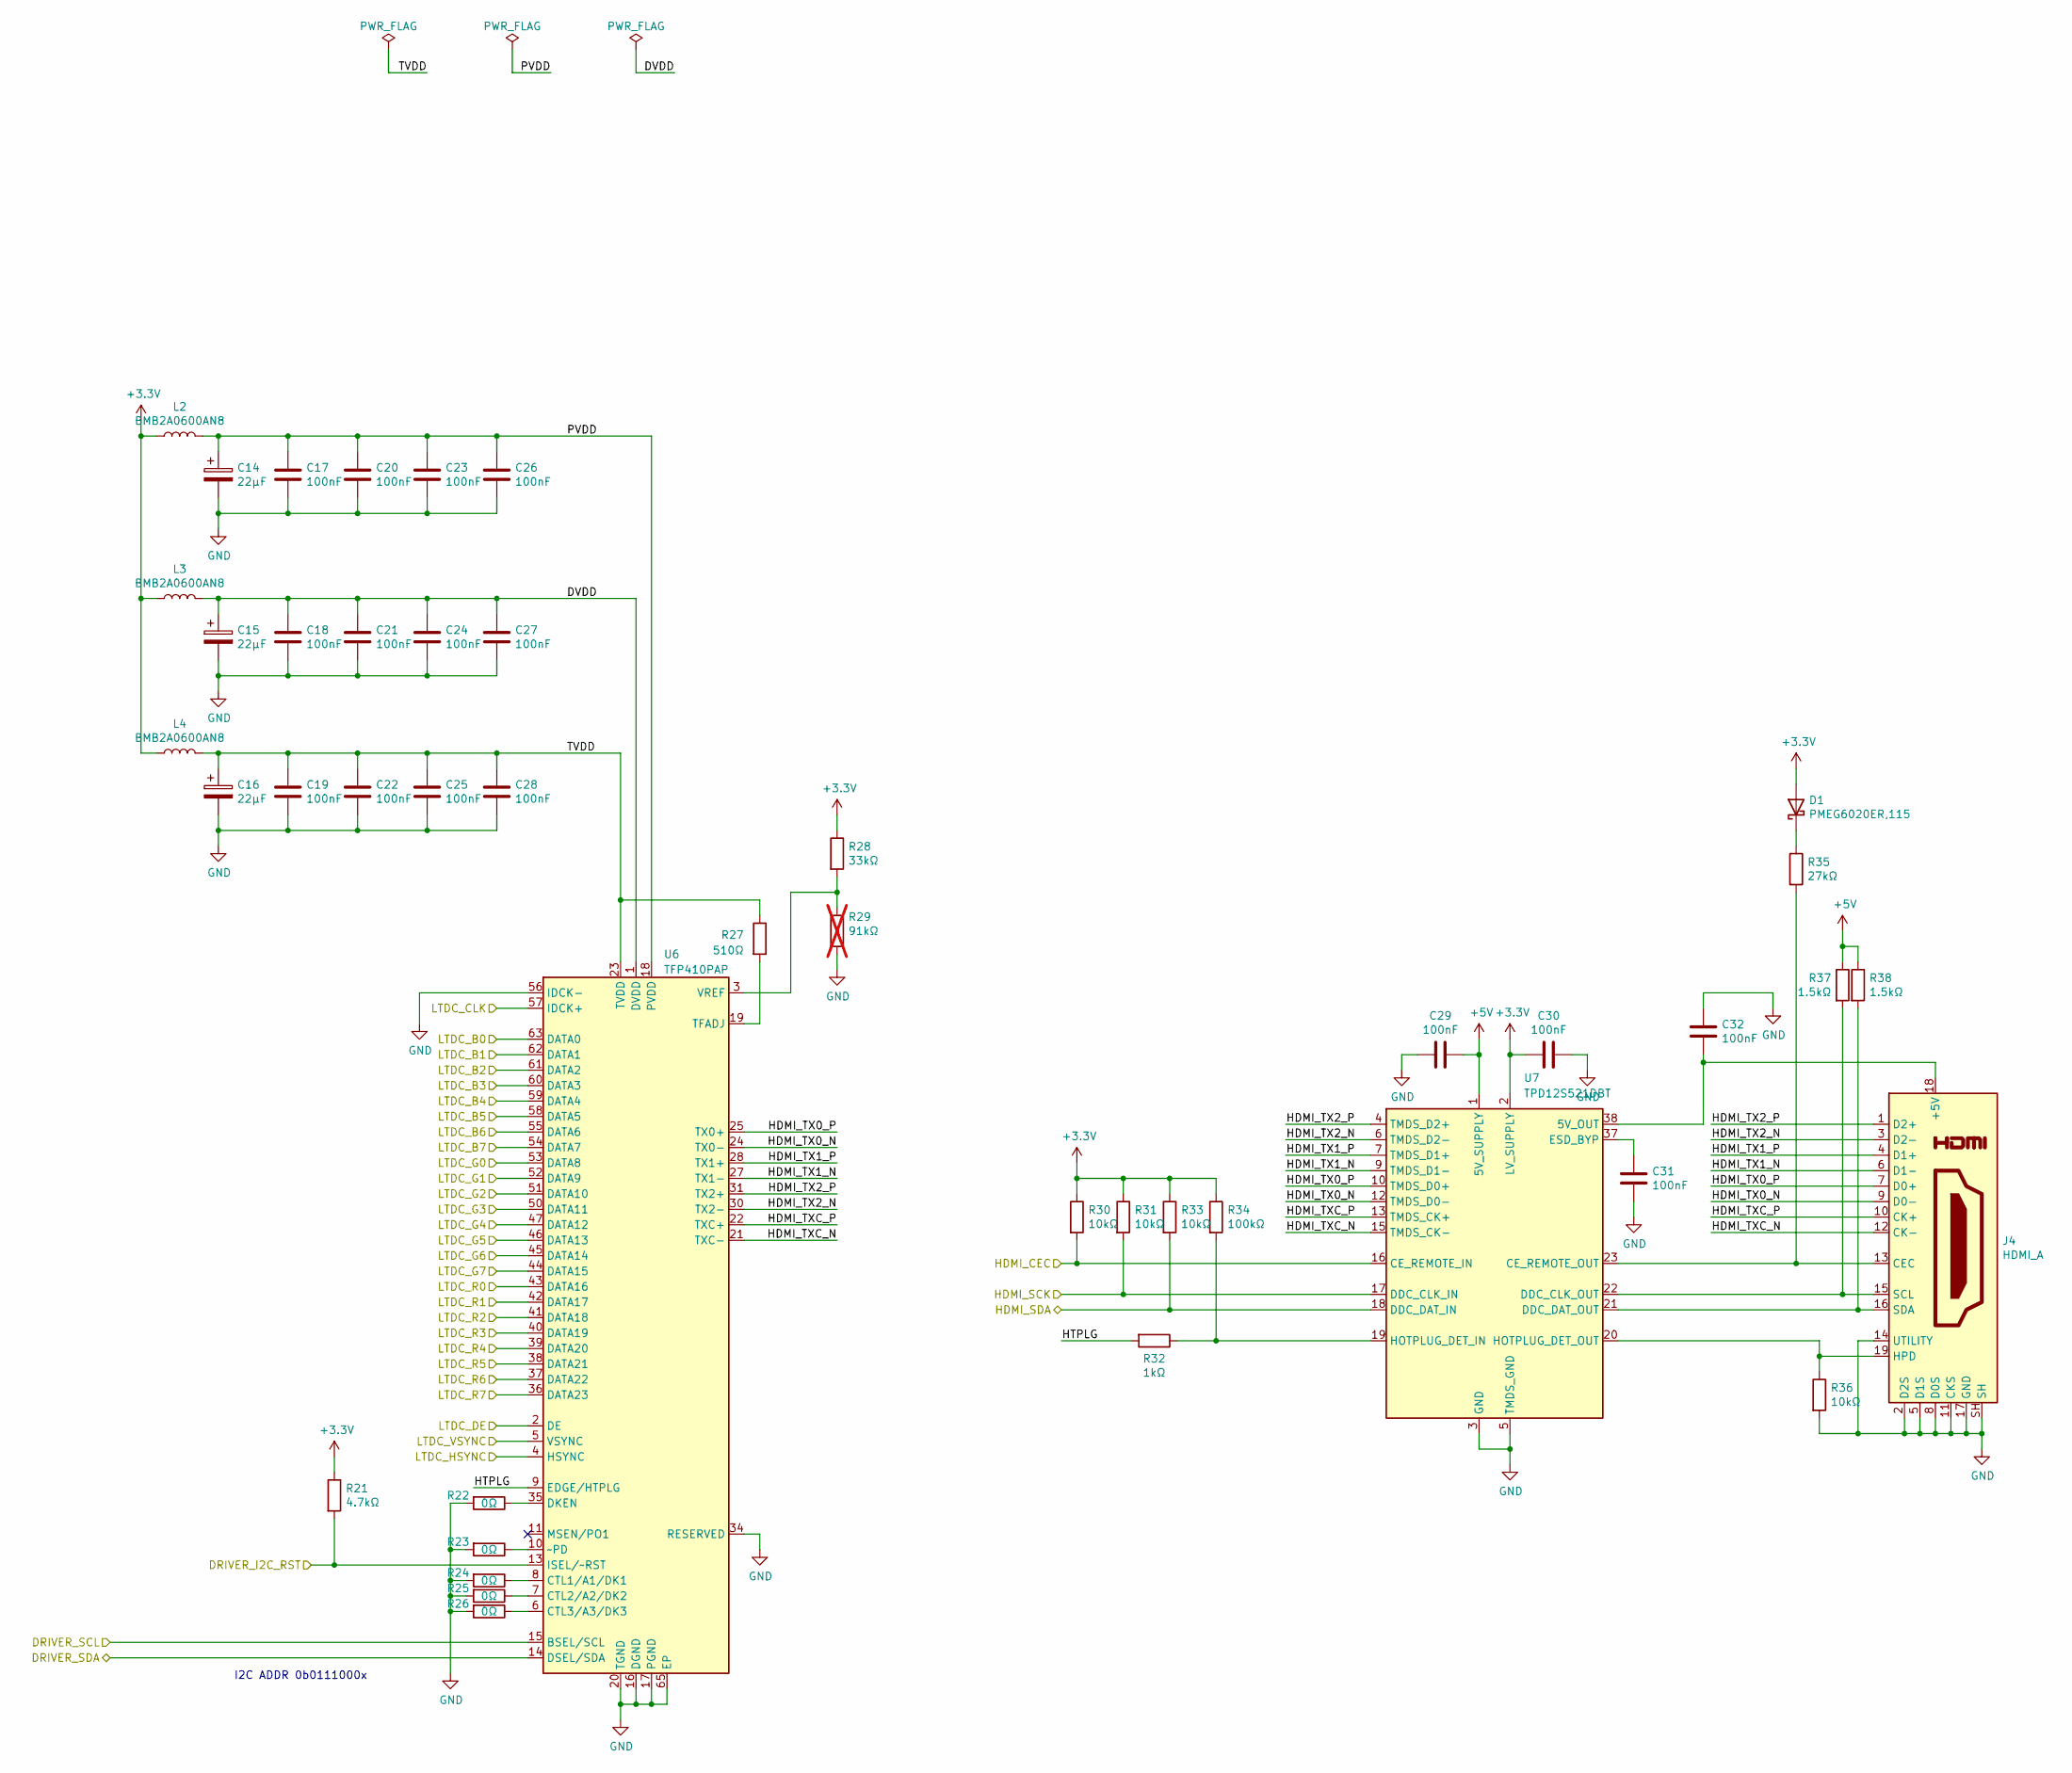
[picture p6: schematic hdmi.kicad_sch]

Parts:
C14, C15, C16: 22µF; CP_EIA-3216-10_Kemet-I_Pad1.58x1.35mm_HandSolder; Farnell 1457420
C17, C18, C19, C20, C21, C22, C23, C24, C25, C26, C27, C28, C29, C30, C31, C32: 100nF; C_0603_1608Metric_Pad1.08x0.95mm_HandSolder; Part number Generic 0603 X7R 50V 10%
D1: PMEG6020ER,115; D_SOD-123
J4: HDMI_A; HDMI_A_Molex_208658-1001_Horizontal
L2, L3, L4: BMB2A0600AN8; L_0805_2012Metric_Pad1.05x1.20mm_HandSolder
R21: 4.7kΩ; R_0603_1608Metric_Pad0.98x0.95mm_HandSolder
R22, R23, R24, R25, R26: 0Ω; R_0603_1608Metric_Pad0.98x0.95mm_HandSolder
R27: 510Ω; R_0603_1608Metric_Pad0.98x0.95mm_HandSolder
R28: 33kΩ; R_0603_1608Metric_Pad0.98x0.95mm_HandSolder
R29: 91kΩ; R_0603_1608Metric_Pad0.98x0.95mm_HandSolder; not fitted
R30, R31, R33, R36: 10kΩ; R_0603_1608Metric_Pad0.98x0.95mm_HandSolder
R32: 1kΩ; R_0603_1608Metric_Pad0.98x0.95mm_HandSolder
R34: 100kΩ; R_0603_1608Metric_Pad0.98x0.95mm_HandSolder
R35: 27kΩ; R_0603_1608Metric_Pad0.98x0.95mm_HandSolder
R37, R38: 1.5kΩ; R_0603_1608Metric_Pad0.98x0.95mm_HandSolder
U6: TFP410PAP; QFP-64_10x10_P0.5mm-1EP8x8-Mask5x5
U7: TPD12S521DBT; TSSOP-38_4.4x9.7mm_P0.5mm

Connections:
+3.3V: C30.2, D1.2 (A), L2.1, L3.1, L4.1, R21.1, R28.1, R30.1, R31.1, R33.1, R34.1, U7.2 (LV_SUPPLY)
+5V: C29.1, R37.1, R38.1, U7.1 (5V_SUPPLY)
DRIVER_I2C_RST: R21.2, U6.13 (ISEL/~RST)
DRIVER_SCL: U6.15 (BSEL/SCL)
DRIVER_SDA: U6.14 (DSEL/SDA)
DVDD: C15.1, C18.1, C21.1, C24.1, C27.1, L3.2, U6.1 (DVDD), U6.12 (DVDD), U6.33 (DVDD)
GND: C14.2, C15.2, C16.2, C17.2, C18.2, C19.2, C20.2, C21.2, C22.2, C23.2, C24.2, C25.2, C26.2, C27.2, C28.2, C29.2, C30.1, C31.2, C32.1, J4.2 (D2S), J4.5 (D1S), J4.8 (D0S), J4.11 (CKS), J4.14 (UTILITY), J4.17 (GND), J4.SH, R22.2, R23.2, R24.2, R25.2, R26.2, R29.2, R36.2, U6.16 (DGND), U6.17 (PGND), U6.20 (TGND), U6.26 (TGND), U6.32 (TGND), U6.34 (RESERVED), U6.48 (DGND), U6.56 (IDCK-), U6.64 (DGND), U6.65 (EP), U7.3 (GND), U7.5 (TMDS_GND), U7.8 (TMDS_GND), U7.11 (TMDS_GND), U7.14 (TMDS_GND), U7.25 (TMDS_GND), U7.28 (TMDS_GND), U7.31 (TMDS_GND), U7.34 (TMDS_GND), U7.36 (GND)
HDMI_CEC: R30.2, U7.16 (CE_REMOTE_IN)
HDMI_SCK: R31.2, U7.17 (DDC_CLK_IN)
HDMI_SDA: R33.2, U7.18 (DDC_DAT_IN)
HDMI_TX0_N: J4.9 (D0-), U6.24 (TX0-), U7.12 (TMDS_D0-), U7.27 (TMDS_D0-)
HDMI_TX0_P: J4.7 (D0+), U6.25 (TX0+), U7.10 (TMDS_D0+), U7.29 (TMDS_D0+)
HDMI_TX1_N: J4.6 (D1-), U6.27 (TX1-), U7.9 (TMDS_D1-), U7.30 (TMDS_D1-)
HDMI_TX1_P: J4.4 (D1+), U6.28 (TX1+), U7.7 (TMDS_D1+), U7.32 (TMDS_D1+)
HDMI_TX2_N: J4.3 (D2-), U6.30 (TX2-), U7.6 (TMDS_D2-), U7.33 (TMDS_D2-)
HDMI_TX2_P: J4.1 (D2+), U6.31 (TX2+), U7.4 (TMDS_D2+), U7.35 (TMDS_D2+)
HDMI_TXC_N: J4.12 (CK-), U6.21 (TXC-), U7.15 (TMDS_CK-), U7.24 (TMDS_CK-)
HDMI_TXC_P: J4.10 (CK+), U6.22 (TXC+), U7.13 (TMDS_CK+), U7.26 (TMDS_CK+)
HTPLG: R32.2, U6.9 (EDGE/HTPLG)
LTDC_B0: U6.63 (DATA0)
LTDC_B1: U6.62 (DATA1)
LTDC_B2: U6.61 (DATA2)
LTDC_B3: U6.60 (DATA3)
LTDC_B4: U6.59 (DATA4)
LTDC_B5: U6.58 (DATA5)
LTDC_B6: U6.55 (DATA6)
LTDC_B7: U6.54 (DATA7)
LTDC_CLK: U6.57 (IDCK+)
LTDC_DE: U6.2 (DE)
LTDC_G0: U6.53 (DATA8)
LTDC_G1: U6.52 (DATA9)
LTDC_G2: U6.51 (DATA10)
LTDC_G3: U6.50 (DATA11)
LTDC_G4: U6.47 (DATA12)
LTDC_G5: U6.46 (DATA13)
LTDC_G6: U6.45 (DATA14)
LTDC_G7: U6.44 (DATA15)
LTDC_HSYNC: U6.4 (HSYNC)
LTDC_R0: U6.43 (DATA16)
LTDC_R1: U6.42 (DATA17)
LTDC_R2: U6.41 (DATA18)
LTDC_R3: U6.40 (DATA19)
LTDC_R4: U6.39 (DATA20)
LTDC_R5: U6.38 (DATA21)
LTDC_R6: U6.37 (DATA22)
LTDC_R7: U6.36 (DATA23)
LTDC_VSYNC: U6.5 (VSYNC)
unnamed: C31.1, U7.37 (ESD_BYP)
unnamed: C32.2, J4.18 (+5V), U7.38 (5V_OUT)
unnamed: D1.1 (K), R35.1
unnamed: J4.13 (CEC), R35.2, U7.23 (CE_REMOTE_OUT)
unnamed: J4.15 (SCL), R37.2, U7.22 (DDC_CLK_OUT)
unnamed: J4.16 (SDA), R38.2, U7.21 (DDC_DAT_OUT)
unnamed: J4.19 (HPD), R36.1, U7.20 (HOTPLUG_DET_OUT)
unnamed: R22.1, U6.35 (DKEN)
unnamed: R23.1, U6.10 (~PD)
unnamed: R24.1, U6.8 (CTL1/A1/DK1)
unnamed: R25.1, U6.7 (CTL2/A2/DK2)
unnamed: R26.1, U6.6 (CTL3/A3/DK3)
unnamed: R27.2, U6.19 (TFADJ)
unnamed: R28.2, R29.1, U6.3 (VREF)
unnamed: R32.1, R34.2, U7.19 (HOTPLUG_DET_IN)
PVDD: C14.1, C17.1, C20.1, C23.1, C26.1, L2.2, U6.18 (PVDD)
TVDD: C16.1, C19.1, C22.1, C25.1, C28.1, L4.2, R27.1, U6.23 (TVDD), U6.29 (TVDD)

Notes on the sheet:
I2C ADDR 0b0111000x
