hairymnstr/d1000_hardware/memory.kicad_sch

## KiCad design memory.kicad_sch (2023-09-26)

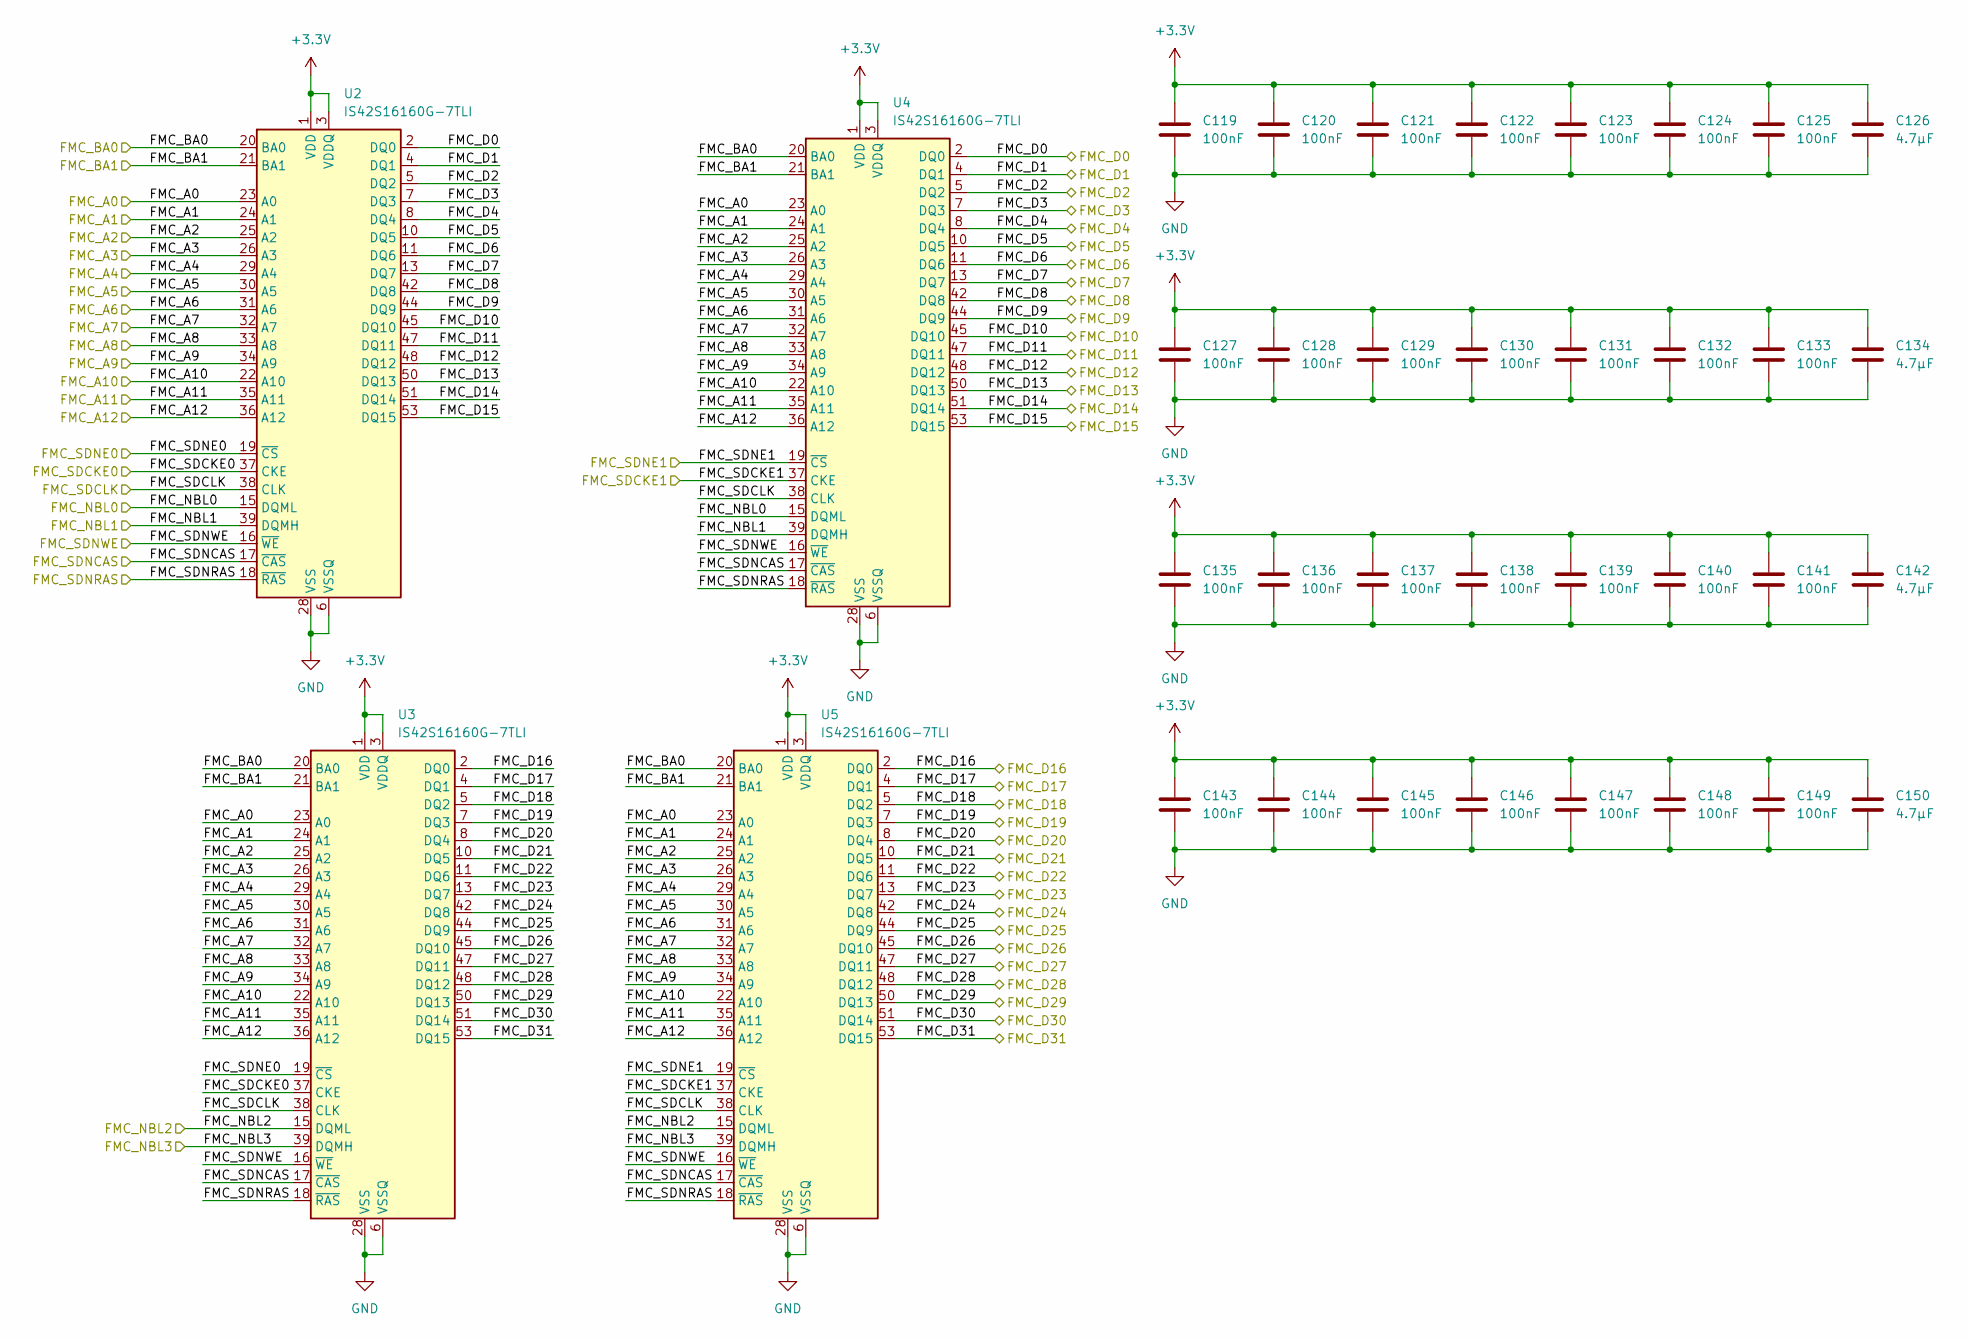
[picture p7: schematic memory.kicad_sch]

Parts:
C119, C120, C121, C122, C123, C124, C125, C127, C128, C129, C130, C131, C132, C133, C135, C136, C137, C138, C139, C140, C141, C143, C144, C145, C146, C147, C148, C149: 100nF; C_0603_1608Metric_Pad1.08x0.95mm_HandSolder; Part number Generic 0603 X7R 50V 10%
C126, C134, C142, C150: 4.7µF; C_0805_2012Metric_Pad1.18x1.45mm_HandSolder
U2, U3, U4, U5: IS42S16160G-7TLI; TSOP-II-54_22.2x10.16mm_P0.8mm

Connections:
+3.3V: C119.1, C120.1, C121.1, C122.1, C123.1, C124.1, C125.1, C126.1, C127.1, C128.1, C129.1, C130.1, C131.1, C132.1, C133.1, C134.1, C135.1, C136.1, C137.1, C138.1, C139.1, C140.1, C141.1, C142.1, C143.1, C144.1, C145.1, C146.1, C147.1, C148.1, C149.1, C150.1, U2.1 (VDD), U2.3 (VDDQ), U2.9 (VDDQ), U2.14 (VDD), U2.27 (VDD), U2.43 (VDDQ), U2.49 (VDDQ), U3.1 (VDD), U3.3 (VDDQ), U3.9 (VDDQ), U3.14 (VDD), U3.27 (VDD), U3.43 (VDDQ), U3.49 (VDDQ), U4.1 (VDD), U4.3 (VDDQ), U4.9 (VDDQ), U4.14 (VDD), U4.27 (VDD), U4.43 (VDDQ), U4.49 (VDDQ), U5.1 (VDD), U5.3 (VDDQ), U5.9 (VDDQ), U5.14 (VDD), U5.27 (VDD), U5.43 (VDDQ), U5.49 (VDDQ)
FMC_A0: U2.23 (A0), U3.23 (A0), U4.23 (A0), U5.23 (A0)
FMC_A1: U2.24 (A1), U3.24 (A1), U4.24 (A1), U5.24 (A1)
FMC_A2: U2.25 (A2), U3.25 (A2), U4.25 (A2), U5.25 (A2)
FMC_A3: U2.26 (A3), U3.26 (A3), U4.26 (A3), U5.26 (A3)
FMC_A4: U2.29 (A4), U3.29 (A4), U4.29 (A4), U5.29 (A4)
FMC_A5: U2.30 (A5), U3.30 (A5), U4.30 (A5), U5.30 (A5)
FMC_A6: U2.31 (A6), U3.31 (A6), U4.31 (A6), U5.31 (A6)
FMC_A7: U2.32 (A7), U3.32 (A7), U4.32 (A7), U5.32 (A7)
FMC_A8: U2.33 (A8), U3.33 (A8), U4.33 (A8), U5.33 (A8)
FMC_A9: U2.34 (A9), U3.34 (A9), U4.34 (A9), U5.34 (A9)
FMC_A10: U2.22 (A10), U3.22 (A10), U4.22 (A10), U5.22 (A10)
FMC_A11: U2.35 (A11), U3.35 (A11), U4.35 (A11), U5.35 (A11)
FMC_A12: U2.36 (A12), U3.36 (A12), U4.36 (A12), U5.36 (A12)
FMC_BA0: U2.20 (BA0), U3.20 (BA0), U4.20 (BA0), U5.20 (BA0)
FMC_BA1: U2.21 (BA1), U3.21 (BA1), U4.21 (BA1), U5.21 (BA1)
FMC_D0: U2.2 (DQ0), U4.2 (DQ0)
FMC_D1: U2.4 (DQ1), U4.4 (DQ1)
FMC_D2: U2.5 (DQ2), U4.5 (DQ2)
FMC_D3: U2.7 (DQ3), U4.7 (DQ3)
FMC_D4: U2.8 (DQ4), U4.8 (DQ4)
FMC_D5: U2.10 (DQ5), U4.10 (DQ5)
FMC_D6: U2.11 (DQ6), U4.11 (DQ6)
FMC_D7: U2.13 (DQ7), U4.13 (DQ7)
FMC_D8: U2.42 (DQ8), U4.42 (DQ8)
FMC_D9: U2.44 (DQ9), U4.44 (DQ9)
FMC_D10: U2.45 (DQ10), U4.45 (DQ10)
FMC_D11: U2.47 (DQ11), U4.47 (DQ11)
FMC_D12: U2.48 (DQ12), U4.48 (DQ12)
FMC_D13: U2.50 (DQ13), U4.50 (DQ13)
FMC_D14: U2.51 (DQ14), U4.51 (DQ14)
FMC_D15: U2.53 (DQ15), U4.53 (DQ15)
FMC_D16: U3.2 (DQ0), U5.2 (DQ0)
FMC_D17: U3.4 (DQ1), U5.4 (DQ1)
FMC_D18: U3.5 (DQ2), U5.5 (DQ2)
FMC_D19: U3.7 (DQ3), U5.7 (DQ3)
FMC_D20: U3.8 (DQ4), U5.8 (DQ4)
FMC_D21: U3.10 (DQ5), U5.10 (DQ5)
FMC_D22: U3.11 (DQ6), U5.11 (DQ6)
FMC_D23: U3.13 (DQ7), U5.13 (DQ7)
FMC_D24: U3.42 (DQ8), U5.42 (DQ8)
FMC_D25: U3.44 (DQ9), U5.44 (DQ9)
FMC_D26: U3.45 (DQ10), U5.45 (DQ10)
FMC_D27: U3.47 (DQ11), U5.47 (DQ11)
FMC_D28: U3.48 (DQ12), U5.48 (DQ12)
FMC_D29: U3.50 (DQ13), U5.50 (DQ13)
FMC_D30: U3.51 (DQ14), U5.51 (DQ14)
FMC_D31: U3.53 (DQ15), U5.53 (DQ15)
FMC_NBL0: U2.15 (DQML), U4.15 (DQML)
FMC_NBL1: U2.39 (DQMH), U4.39 (DQMH)
FMC_NBL2: U3.15 (DQML), U5.15 (DQML)
FMC_NBL3: U3.39 (DQMH), U5.39 (DQMH)
FMC_SDCKE0: U2.37 (CKE), U3.37 (CKE)
FMC_SDCKE1: U4.37 (CKE), U5.37 (CKE)
FMC_SDCLK: U2.38 (CLK), U3.38 (CLK), U4.38 (CLK), U5.38 (CLK)
FMC_SDNCAS: U2.17 (~CAS), U3.17 (~CAS), U4.17 (~CAS), U5.17 (~CAS)
FMC_SDNE0: U2.19 (~CS), U3.19 (~CS)
FMC_SDNE1: U4.19 (~CS), U5.19 (~CS)
FMC_SDNRAS: U2.18 (~RAS), U3.18 (~RAS), U4.18 (~RAS), U5.18 (~RAS)
FMC_SDNWE: U2.16 (~WE), U3.16 (~WE), U4.16 (~WE), U5.16 (~WE)
GND: C119.2, C120.2, C121.2, C122.2, C123.2, C124.2, C125.2, C126.2, C127.2, C128.2, C129.2, C130.2, C131.2, C132.2, C133.2, C134.2, C135.2, C136.2, C137.2, C138.2, C139.2, C140.2, C141.2, C142.2, C143.2, C144.2, C145.2, C146.2, C147.2, C148.2, C149.2, C150.2, U2.6 (VSSQ), U2.12 (VSSQ), U2.28 (VSS), U2.41 (VSS), U2.46 (VSSQ), U2.52 (VSSQ), U2.54 (VSS), U3.6 (VSSQ), U3.12 (VSSQ), U3.28 (VSS), U3.41 (VSS), U3.46 (VSSQ), U3.52 (VSSQ), U3.54 (VSS), U4.6 (VSSQ), U4.12 (VSSQ), U4.28 (VSS), U4.41 (VSS), U4.46 (VSSQ), U4.52 (VSSQ), U4.54 (VSS), U5.6 (VSSQ), U5.12 (VSSQ), U5.28 (VSS), U5.41 (VSS), U5.46 (VSSQ), U5.52 (VSSQ), U5.54 (VSS)
