hairymnstr/d1000_hardware/power.kicad_sch

## KiCad design power.kicad_sch (2023-09-26)

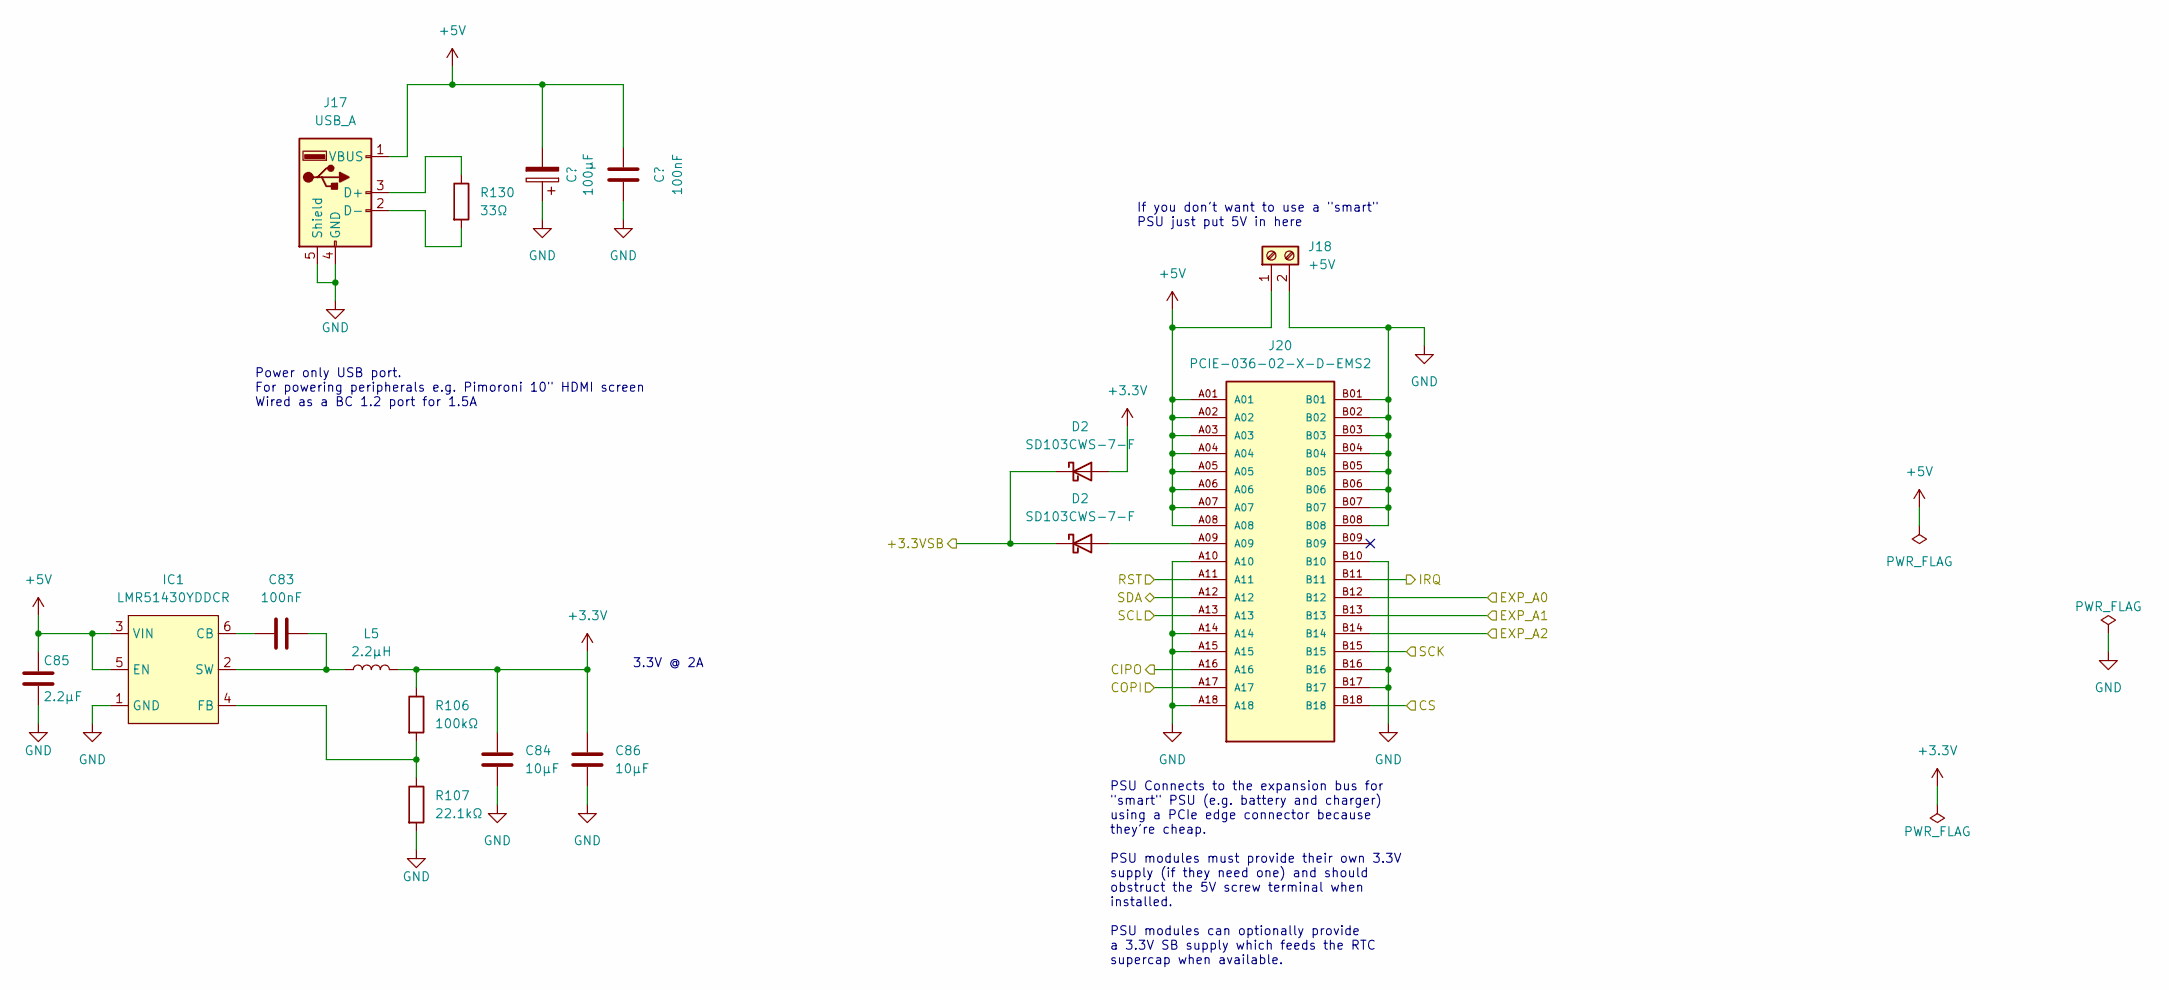
[picture p8: schematic power.kicad_sch]

Parts:
C83: 100µF; CP_Elec_8x6.2
C84, C86: 10µF; C_0805_2012Metric_Pad1.18x1.45mm_HandSolder
C85: 2.2µF; C_0603_1608Metric_Pad1.08x0.95mm_HandSolder
C97: 100nF; C_0603_1608Metric_Pad1.08x0.95mm_HandSolder; Part number Generic 0603 X7R 50V 10%
D2: SD103CWS-7-F; D_SOD-323_HandSoldering
IC1: LMR51430YDDCR; SOT-23-6_Handsoldering
J17: USB_A; USB_A_Molex_67643_Horizontal
J18: +5V; TerminalBlock_bornier-2_P5.08mm
J20: PCIE-036-02-X-D-EMS2; SAMTEC_PCIE-036-02-X-D-EMS2
L5: 2.2µH; L_1008_2520Metric_Pad1.43x2.20mm_HandSolder
R106: 100kΩ; R_0603_1608Metric_Pad0.98x0.95mm_HandSolder
R107: 22.1kΩ; R_0603_1608Metric_Pad0.98x0.95mm_HandSolder
R130: 33Ω; R_0603_1608Metric_Pad0.98x0.95mm_HandSolder

Connections:
+3.3V: C84.1, C86.1, D2.2 (A), L5.2, R106.1
+3.3VSB: D2.1 (K)
+5V: C83.2, C85.1, C97.1, IC1.3 (VIN), IC1.5 (EN), J17.1 (VBUS), J18.1, J20.A01, J20.A02, J20.A03, J20.A04, J20.A05, J20.A06, J20.A07, J20.A08
CIPO: J20.A16
COPI: J20.A17
CS: J20.B18
EXP_A0: J20.B12
EXP_A1: J20.B13
EXP_A2: J20.B14
GND: C83.1, C84.2, C85.2, C86.2, C97.2, IC1.1 (GND), J17.4 (GND), J17.5 (Shield), J18.2, J20.A10, J20.A14, J20.A15, J20.A18, J20.B01, J20.B02, J20.B03, J20.B04, J20.B05, J20.B06, J20.B07, J20.B08, J20.B10, J20.B16, J20.B17, R107.2
IRQ: J20.B11
unnamed: C83.1, IC1.6 (CB)
unnamed: C83.2, IC1.2 (SW), L5.1
unnamed: D2.2 (A), J20.A09
unnamed: IC1.4 (FB), R106.2, R107.1
unnamed: J17.2 (D-), R130.2
unnamed: J17.3 (D+), R130.1
RST: J20.A11
SCK: J20.B15
SCL: J20.A13
SDA: J20.A12

Notes on the sheet:
If you don't want to use a "smart" PSU just put 5V in here
3.3V @ 2A
PSU Connects to the expansion bus for "smart" PSU (e.g. battery and charger) using a PCIe edge connector because they're cheap. PSU modules must provide their own 3.3V supply (if they need one) and should obstruct the 5V screw terminal when installed. PSU modules can optionally provide a 3.3V SB su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
Power only USB port. For powering peripherals e.g. Pimoroni 10" HDMI screen Wired as a BC 1.2 port for 1.5A
