hairymnstr/d1000_hardware/sdcard_sdio.kicad_sch

## KiCad design sdcard_sdio.kicad_sch (2023-11-03)

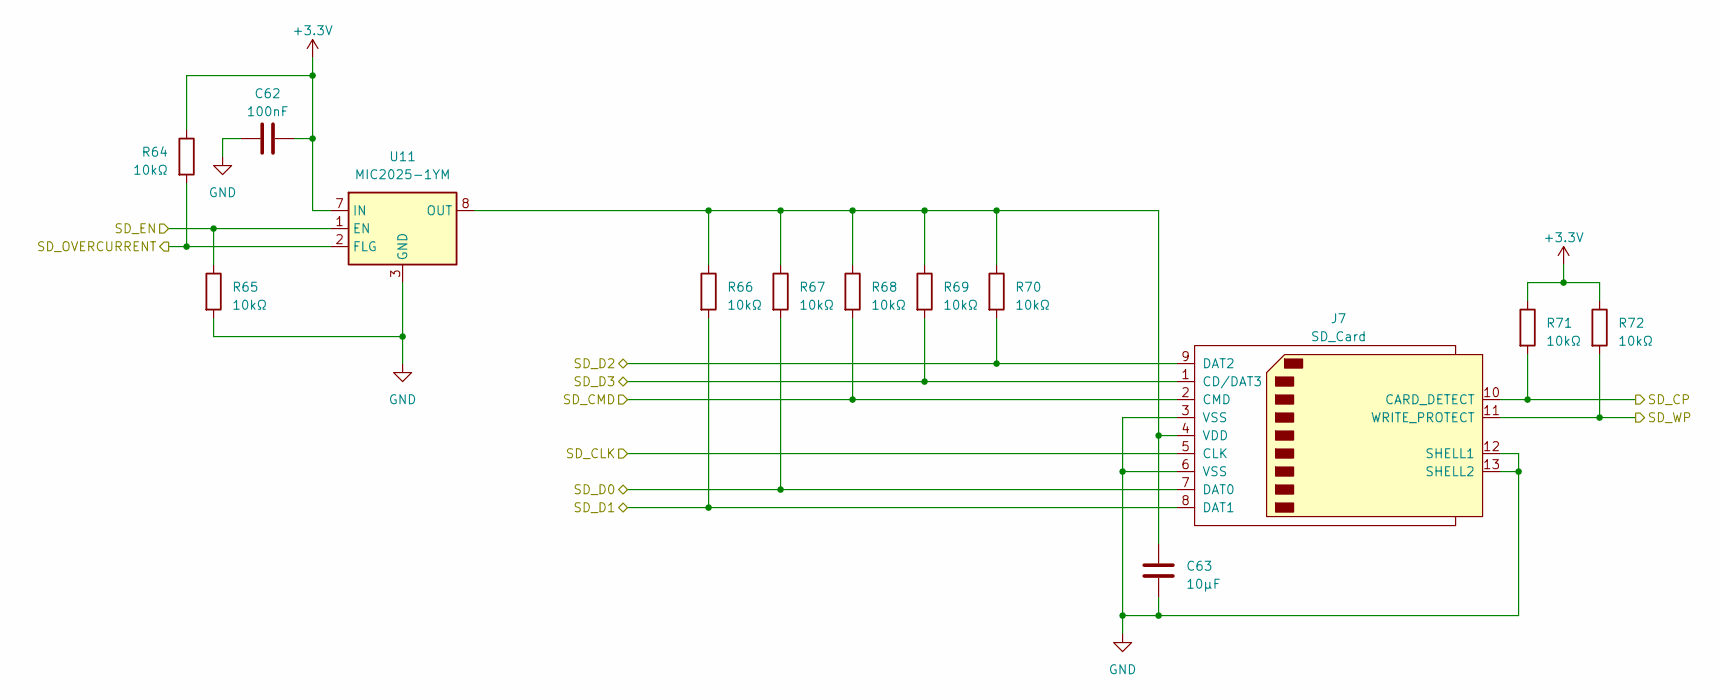
[picture p9: schematic sdcard_sdio.kicad_sch]

Parts:
C62: 100nF; C_0603_1608Metric_Pad1.08x0.95mm_HandSolder; Part number Generic 0603 X7R 50V 10%
C63: 10µF; C_0805_2012Metric_Pad1.18x1.45mm_HandSolder
J7: SD_Card; SD_UNIVERSAL
R64, R65, R66, R67, R68, R69, R70, R71, R72: 10kΩ; R_0603_1608Metric_Pad0.98x0.95mm_HandSolder
U11: MIC2025-1YM; SOIC-8_3.9x4.9mm_P1.27mm

Connections:
+3.3V: C62.2, R64.1, R71.1, R72.1, U11.7 (IN)
GND: C62.1, C63.2, J7.3 (VSS), J7.6 (VSS), J7.12 (SHELL1), J7.13 (SHELL2), R65.2, U11.3 (GND)
unnamed: C63.1, J7.4 (VDD), R66.1, R67.1, R68.1, R69.1, R70.1, U11.6 (OUT), U11.8 (OUT)
SD_CLK: J7.5 (CLK)
SD_CMD: J7.2 (CMD), R68.2
SD_CP: J7.10 (CARD_DETECT), R71.2
SD_D0: J7.7 (DAT0), R67.2
SD_D1: J7.8 (DAT1), R66.2
SD_D2: J7.9 (DAT2), R70.2
SD_D3: J7.1 (CD/DAT3), R69.2
SD_EN: R65.1, U11.1 (EN)
SD_OVERCURRENT: R64.2, U11.2 (FLG)
SD_WP: J7.11 (WRITE_PROTECT), R72.2
