hairymnstr/d1000_hardware/usb.kicad_sch

## KiCad design usb.kicad_sch (2023-09-26)

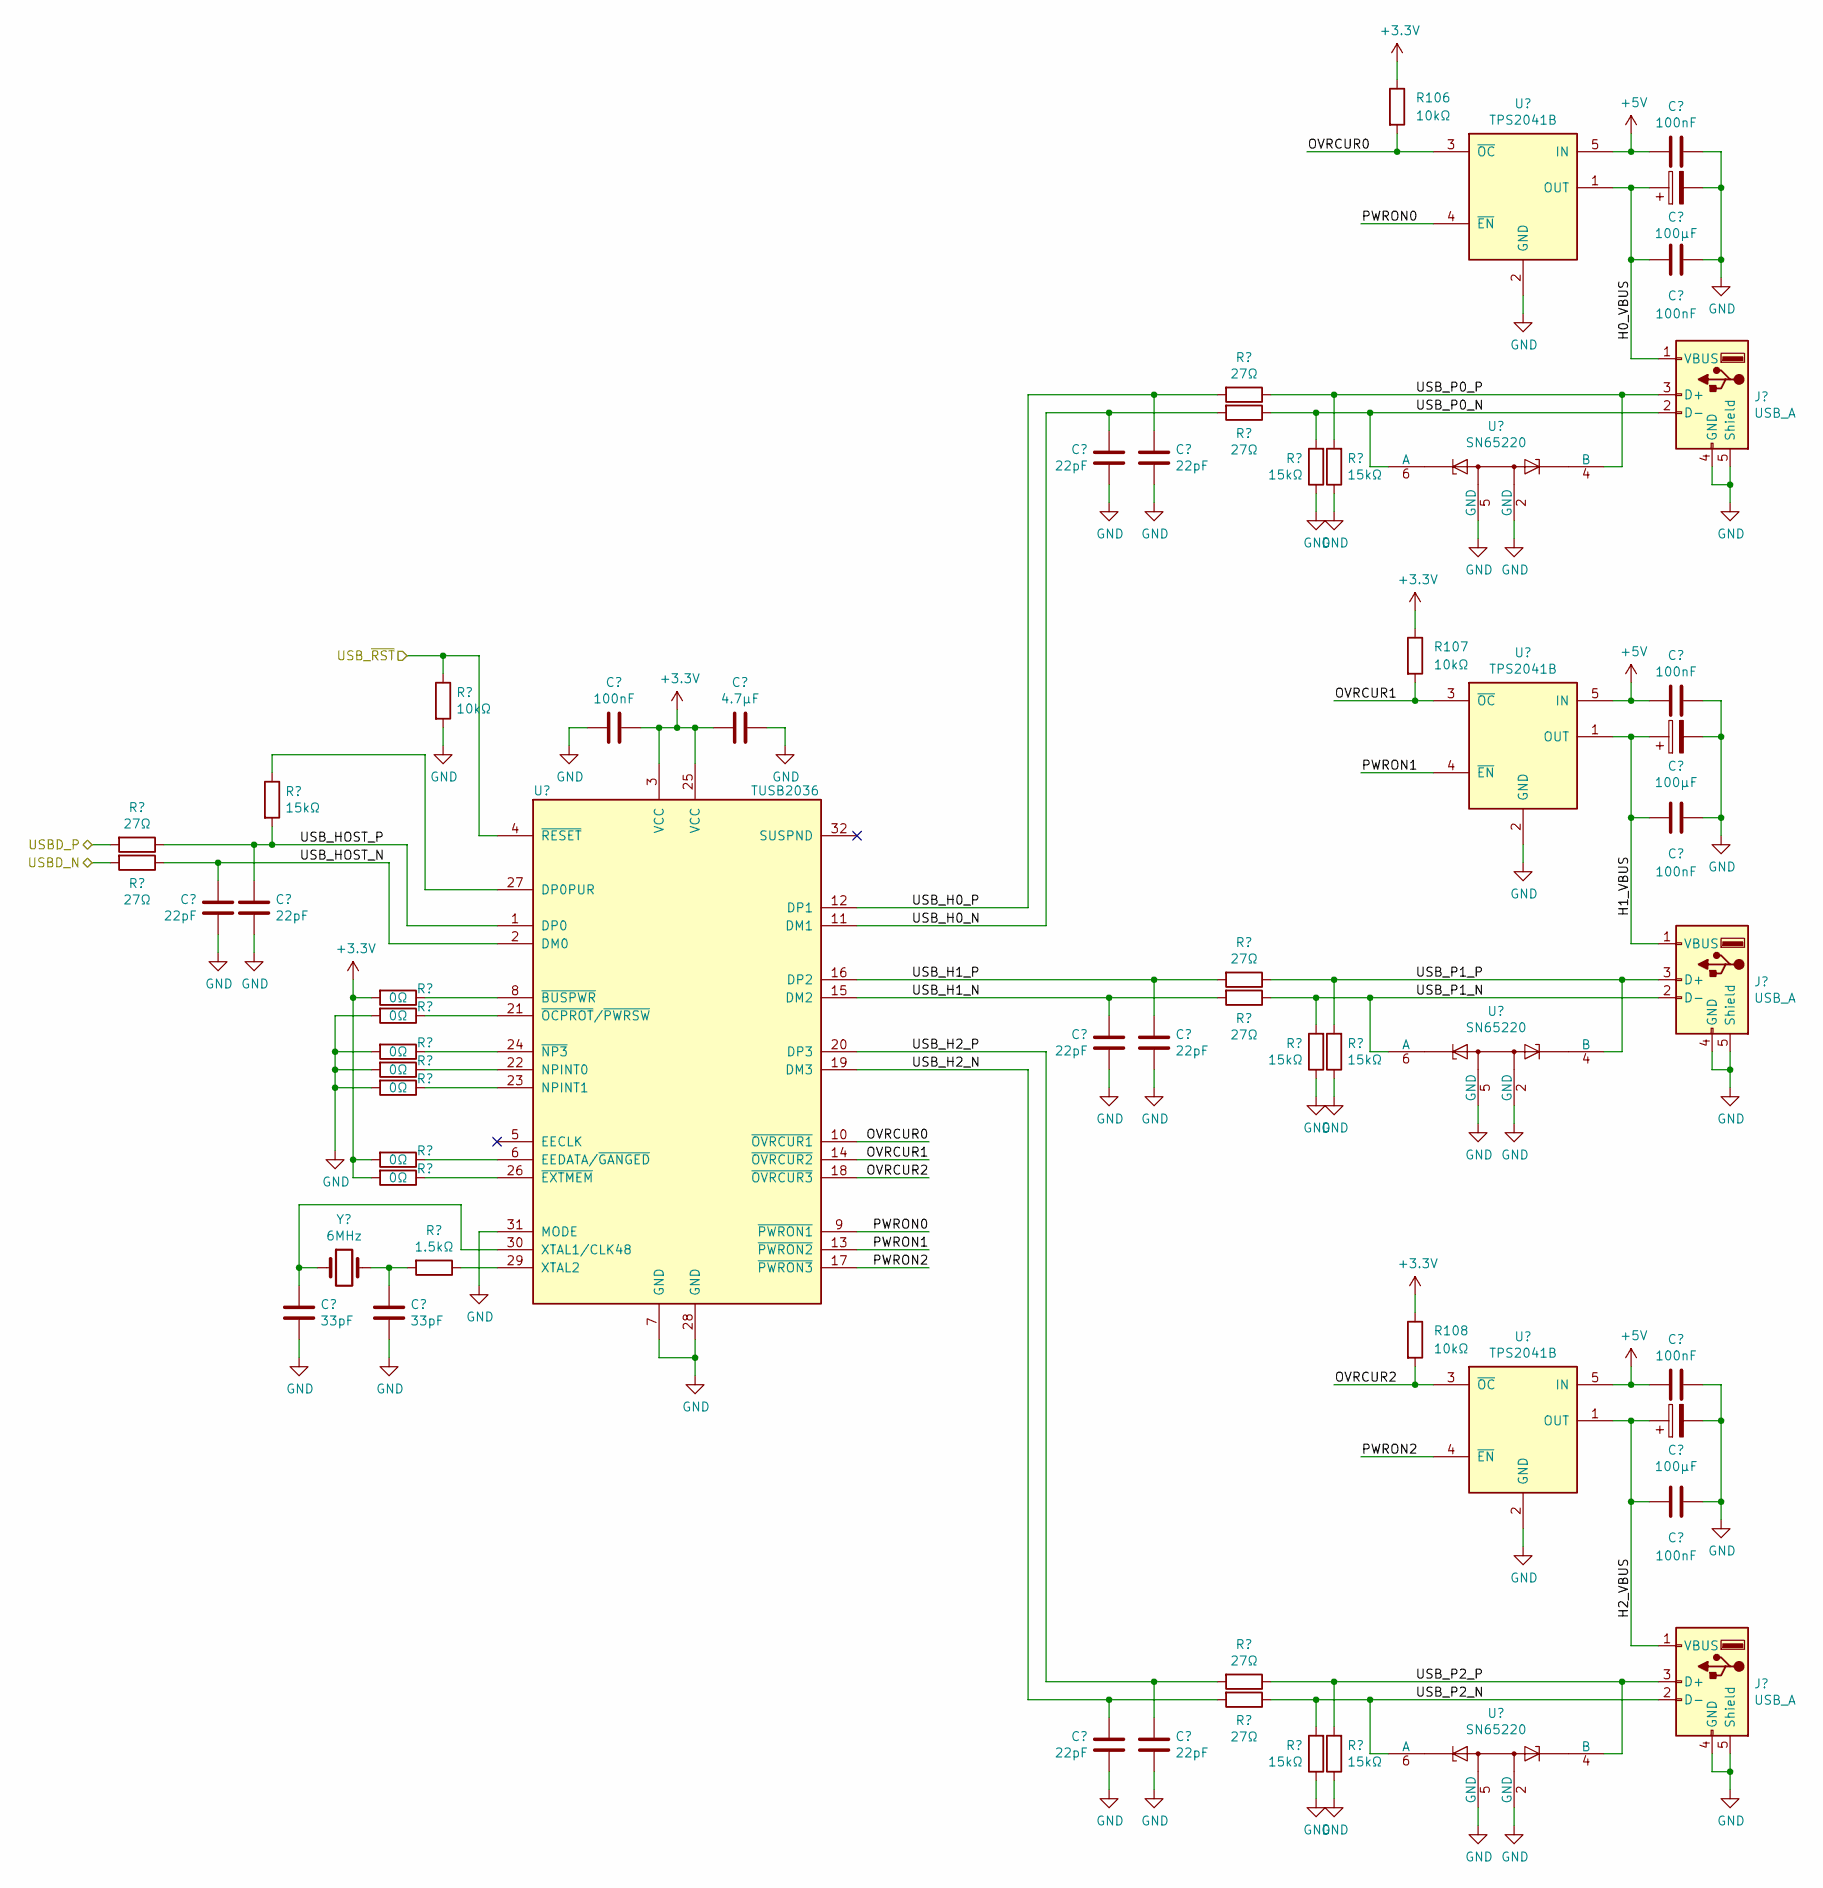
[picture p10: schematic usb.kicad_sch]

Parts:
C66, C67, C72, C73, C74, C75, C76, C77: 22pF; C_0603_1608Metric_Pad1.08x0.95mm_HandSolder
C68, C69: 33pF; C_0603_1608Metric_Pad1.08x0.95mm_HandSolder
C70, C78, C80, C82, C95, C96, C97: 100nF; C_0603_1608Metric_Pad1.08x0.95mm_HandSolder; Part number Generic 0603 X7R 50V 10%
C71: 4.7µF; C_0805_2012Metric_Pad1.18x1.45mm_HandSolder
C79, C81, C83: 100µF; CP_Elec_8x6.2
J9, J10, J11: USB_A; USB_A_Molex_67643_Horizontal
R82, R83, R94, R95, R96, R97, R98, R99: 27Ω; R_0603_1608Metric_Pad0.98x0.95mm_HandSolder
R84, R100, R101, R102, R103, R104, R105: 15kΩ; R_0603_1608Metric_Pad0.98x0.95mm_HandSolder
R85, R86, R87, R88, R89, R90, R91: 0Ω; R_0603_1608Metric_Pad0.98x0.95mm_HandSolder
R92: 1.5kΩ; R_0603_1608Metric_Pad0.98x0.95mm_HandSolder
R93, R106, R107, R108: 10kΩ; R_0603_1608Metric_Pad0.98x0.95mm_HandSolder
U13: TUSB2036; LQFP-32_7x7mm_P0.8mm
U14, U15, U16: SN65220; SOT-23-6
U17, U18, U19: TPS2041B; SOT-23-5
Y3: 6MHz; Crystal_SMD_HC49-SD; Part number ABLS-6.000MHZ-20-B-4-Y-T

Connections:
+3.3V: C70.1, C71.2, R85.2, R90.2, R91.2, R106.1, R107.1, R108.1, U13.3 (VCC), U13.25 (VCC)
+5V: C78.2, C80.2, C82.2, U17.5 (IN), U18.5 (IN), U19.5 (IN)
GND: C66.2, C67.2, C68.2, C69.2, C70.2, C71.1, C72.2, C73.2, C74.2, C75.2, C76.2, C77.2, C78.1, C79.2, C80.1, C81.2, C82.1, C83.2, C95.1, C96.1, C97.1, J9.4 (GND), J9.5 (Shield), J10.4 (GND), J10.5 (Shield), J11.4 (GND), J11.5 (Shield), R86.2, R87.2, R88.2, R89.2, R93.2, R100.1, R101.1, R102.1, R103.1, R104.1, R105.1, U13.7 (GND), U13.28 (GND), U13.31 (MODE), U14.2 (GND), U14.5 (GND), U15.2 (GND), U15.5 (GND), U16.2 (GND), U16.5 (GND), U17.2 (GND), U18.2 (GND), U19.2 (GND)
H0_VBUS: C79.1, C95.2, J9.1 (VBUS), U17.1 (OUT)
H1_VBUS: C81.1, C96.2, J10.1 (VBUS), U18.1 (OUT)
H2_VBUS: C83.1, C97.2, J11.1 (VBUS), U19.1 (OUT)
unnamed: C68.1, U13.30 (XTAL1/CLK48), Y3.1
unnamed: C69.1, R92.2, Y3.2
unnamed: R84.1, U13.27 (DP0PUR)
unnamed: R85.1, U13.8 (~BUSPWR)
unnamed: R86.1, U13.21 (~OCPROT/~PWRSW)
unnamed: R87.1, U13.24 (~NP3)
unnamed: R88.1, U13.22 (NPINT0)
unnamed: R89.1, U13.23 (NPINT1)
unnamed: R90.1, U13.6 (EEDATA/~GANGED)
unnamed: R91.1, U13.26 (~EXTMEM)
unnamed: R92.1, U13.29 (XTAL2)
OVRCUR0: R106.2, U13.10 (~OVRCUR1), U17.3 (~OC)
OVRCUR1: R107.2, U13.14 (~OVRCUR2), U18.3 (~OC)
OVRCUR2: R108.2, U13.18 (~OVRCUR3), U19.3 (~OC)
PWRON0: U13.9 (~PWRON1), U17.4 (~EN)
PWRON1: U13.13 (~PWRON2), U18.4 (~EN)
PWRON2: U13.17 (~PWRON3), U19.4 (~EN)
USBD_N: R83.2
USBD_P: R82.2
USB_H0_N: C72.1, R95.2, U13.11 (DM1)
USB_H0_P: C75.1, R94.2, U13.12 (DP1)
USB_H1_N: C73.1, R97.2, U13.15 (DM2)
USB_H1_P: C76.1, R96.2, U13.16 (DP2)
USB_H2_N: C74.1, R99.2, U13.19 (DM3)
USB_H2_P: C77.1, R98.2, U13.20 (DP3)
USB_HOST_N: C66.1, R83.1, U13.2 (DM0)
USB_HOST_P: C67.1, R82.1, R84.2, U13.1 (DP0)
USB_P0_N: J9.2 (D-), R95.1, R100.2, U14.1, U14.6 (A)
USB_P0_P: J9.3 (D+), R94.1, R103.2, U14.3, U14.4 (B)
USB_P1_N: J10.2 (D-), R97.1, R101.2, U15.1, U15.6 (A)
USB_P1_P: J10.3 (D+), R96.1, R104.2, U15.3, U15.4 (B)
USB_P2_N: J11.2 (D-), R99.1, R102.2, U16.1, U16.6 (A)
USB_P2_P: J11.3 (D+), R98.1, R105.2, U16.3, U16.4 (B)
USB_~RST: R93.1, U13.4 (~RESET)
