hairymnstr/d1000_hardware/wifi.kicad_sch

## KiCad design wifi.kicad_sch (2023-09-26)

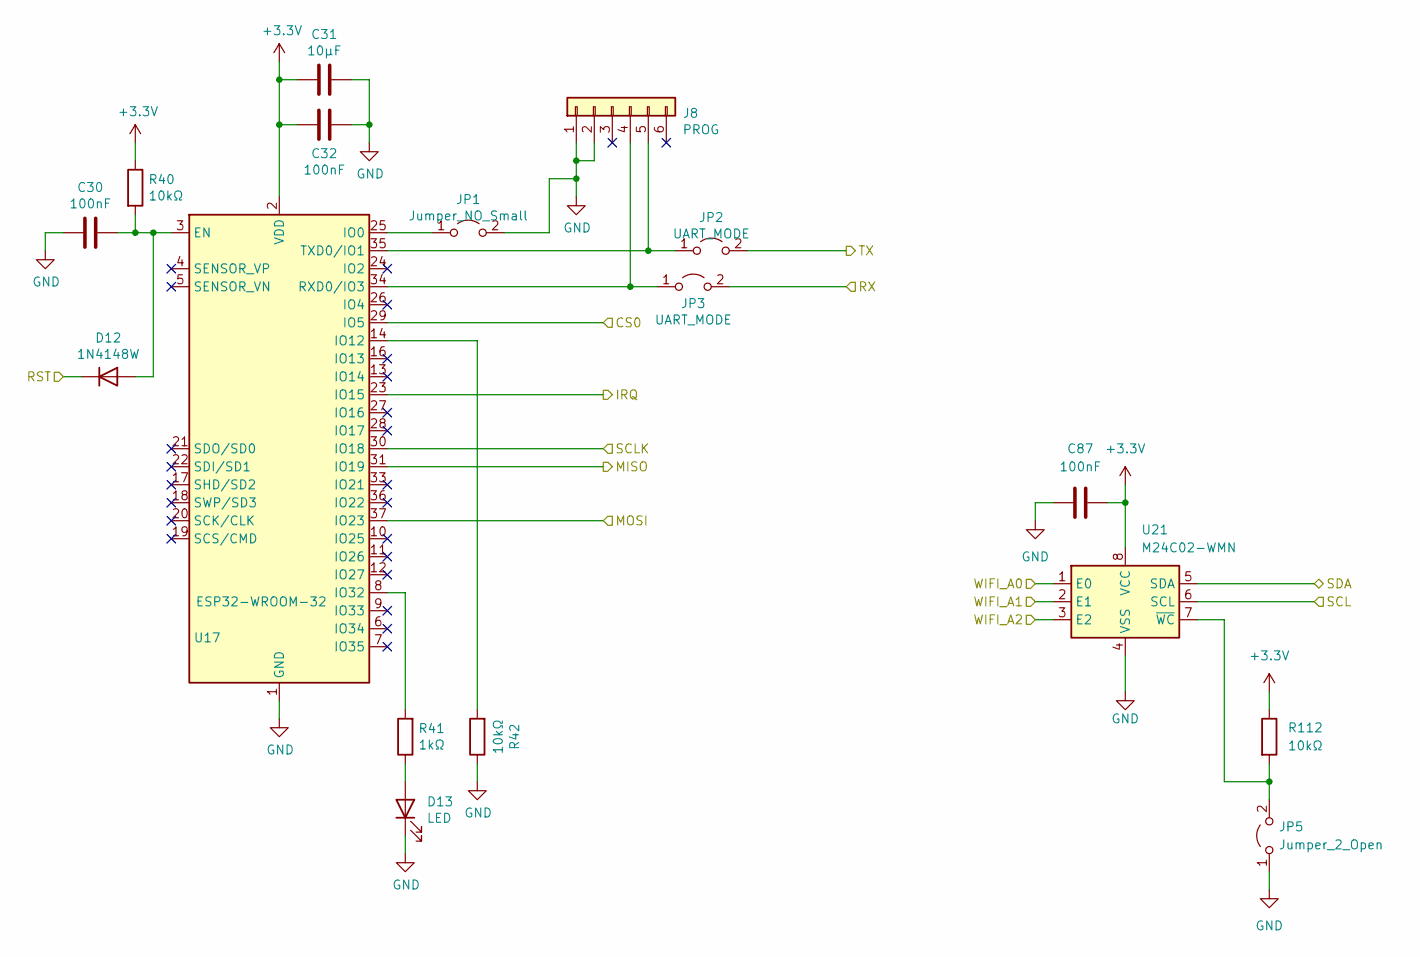
[picture p11: schematic wifi.kicad_sch]

Parts:
C30, C32, C87: 100nF; C_0603_1608Metric_Pad1.08x0.95mm_HandSolder; Part number Generic 0603 X7R 50V 10%
C31: 10µF; C_0805_2012Metric_Pad1.18x1.45mm_HandSolder
D12: 1N4148W; D_SOD-123F
D13: LED; D_0603_1608Metric
J8: PROG; PinHeader_1x06_P2.54mm_Vertical
JP1: Jumper_NO_Small; PinHeader_1x02_P2.54mm_Vertical
JP2, JP3: UART_MODE; PinHeader_1x02_P2.54mm_Vertical
JP5: Jumper_2_Open; PinHeader_1x02_P2.54mm_Vertical
R40, R42, R112: 10kΩ; R_0603_1608Metric_Pad0.98x0.95mm_HandSolder
R41: 1kΩ; R_0603_1608Metric_Pad0.98x0.95mm_HandSolder
U17: ESP32-WROOM-32
U21: M24C02-WMN; SOIC-8_3.9x4.9mm_P1.27mm

Connections:
+3.3V: C31.2, C32.2, C87.2, R40.1, R112.1, U17.2 (VDD), U21.8 (VCC)
CS0: U17.29 (IO5)
GND: C30.2, C31.1, C32.1, C87.1, D13.1 (K), J8.1, J8.2, JP1.2 (B), JP5.1 (A), R42.1, U17.1 (GND), U17.15 (GND), U17.38 (GND), U17.39 (GND), U21.4 (VSS)
IRQ: U17.23 (IO15)
MISO: U17.31 (IO19)
MOSI: U17.37 (IO23)
unnamed: C30.1, D12.2 (A), R40.2, U17.3 (EN)
unnamed: D13.2 (A), R41.1
unnamed: J8.4, JP3.1 (A), U17.34 (RXD0/IO3)
unnamed: J8.5, JP2.1 (A), U17.35 (TXD0/IO1)
unnamed: JP1.1 (A), U17.25 (IO0)
unnamed: JP5.2 (B), R112.2, U21.7 (~WC)
unnamed: R41.2, U17.8 (IO32)
unnamed: R42.2, U17.14 (IO12)
RST: D12.1 (K)
RX: JP3.2 (B)
SCL: U21.6 (SCL)
SCLK: U17.30 (IO18)
SDA: U21.5 (SDA)
TX: JP2.2 (B)
WIFI_A0: U21.1 (E0)
WIFI_A1: U21.2 (E1)
WIFI_A2: U21.3 (E2)
