hairymnstr/d1000_hardware/(commit log)

2023-09-26 Board design done. Needs some BOM work
    [audio.kicad_sch, cpu.kicad_sch, d1000.kicad_sch, ethernet.kicad_sch, expansion.kicad_sch, hdmi.kicad_sch, memory.kicad_sch, power.kicad_sch]
2023-11-03 Corrected part number for the SD Card load switch
    The MIC2025-2 is active low so the pull-down enables it by default
    (not what was intended) the MIC2025-1 is active high input and is
    what this circuit was designed for.
    [sdcard_sdio.kicad_sch]
